grodansparadis/can4vscp_beijing/eagle/Gerbers/bejing_specification.txt

Ake Hedman
Grodans Paradis AB, <akhe@grodansparadis.com>

Date:				2014-06-18
Part Number: 		Beijing
Number of boards: 	120
Number of layers: 	2	 
Material: 			FR4
Final Thickness:	1.6 mm
Final copper:		1/1oz
Surface treatment: 	ENIG
Unit Size:			72 x 42 mm
Panel Size:			154*126 mm
Unit/panel:			6
Solder Mask:		Green
Silk Screen: 		White	
Outline Profile:	CNC Routing + V-cut
X-out Allowed:		1
Stencil needed:		yes
Gerber layer for Stencil: Component Cream (pmc)
