grodansparadis/can4vscp_beijing/docs/_coverpage.md

VSCP logo

# Manual for the Beijing module

Scroll down to view docs.

[Homepage](https://www.vscp.org)
[Docs](https://www.vscp.org/#documentation)
[Get Started](./README)
