grodansparadis/can4vscp_beijing/docs/images/beijing1.png

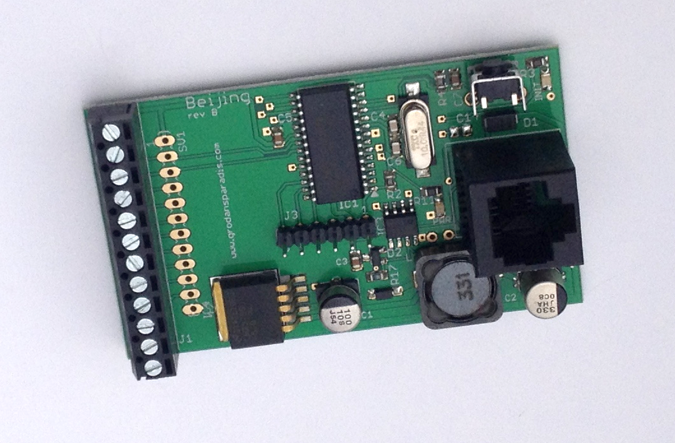
docs/images/beijing1.png
