grodansparadis/can4vscp_beijing/docs/images/beijing2.png

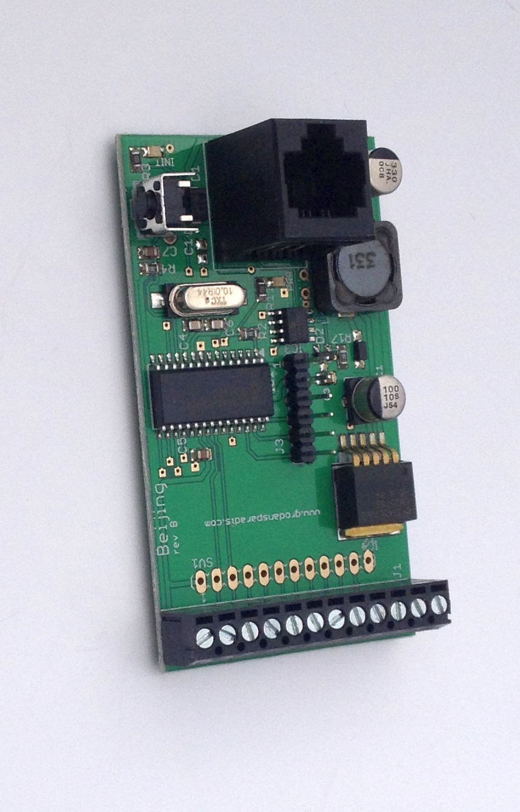
docs/images/beijing2.png
