grodansparadis/can4vscp_beijing/docs/images/beijing4.png

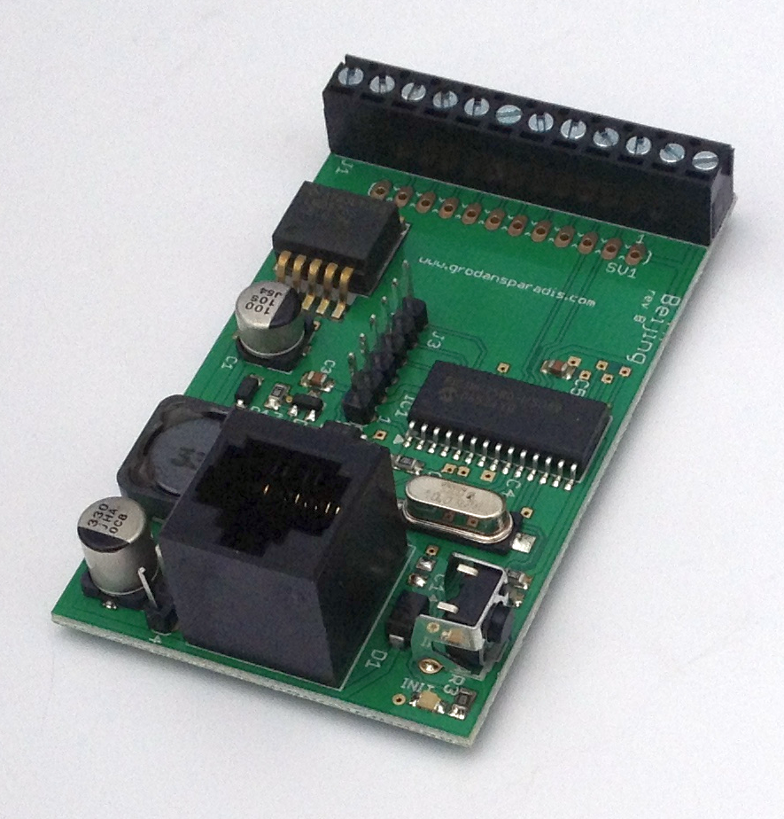
docs/images/beijing4.png
