grodansparadis/can4vscp_beijing/docs/images/beijing5.png

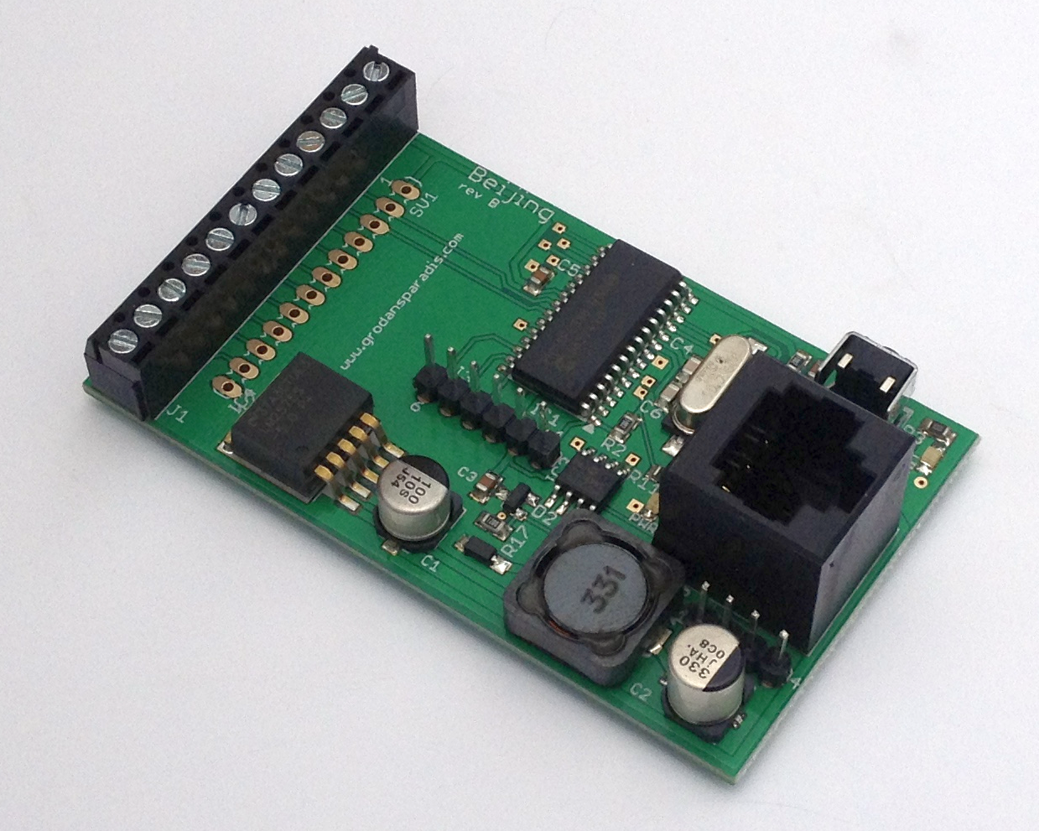
docs/images/beijing5.png
