grodansparadis/can4vscp_beijing/docs/images/beijing6.png

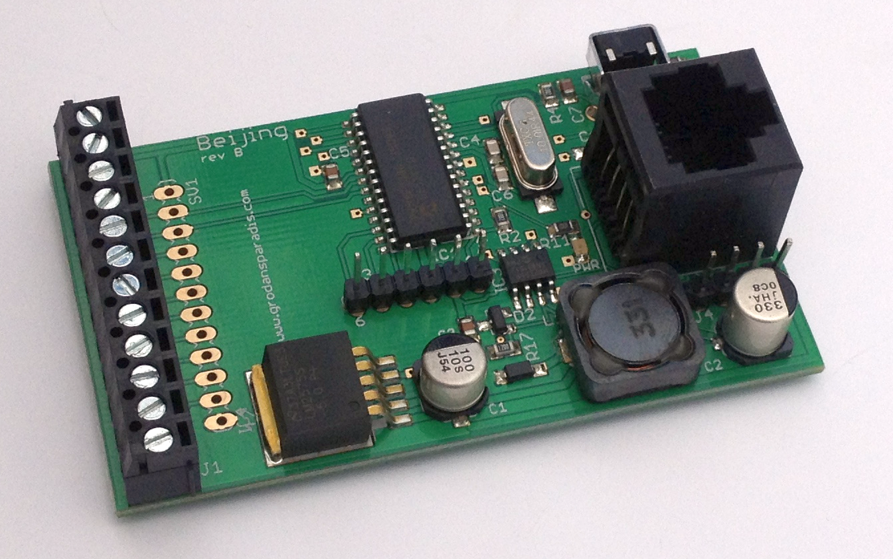
docs/images/beijing6.png
