grodansparadis/can4vscp_beijing/docs/images/beijing7.png

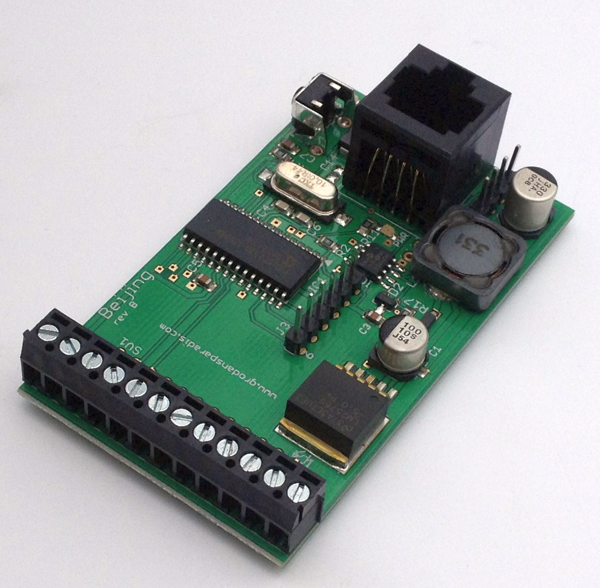
docs/images/beijing7.png
