grodansparadis/can4vscp_beijing/docs/images/beijing8.png

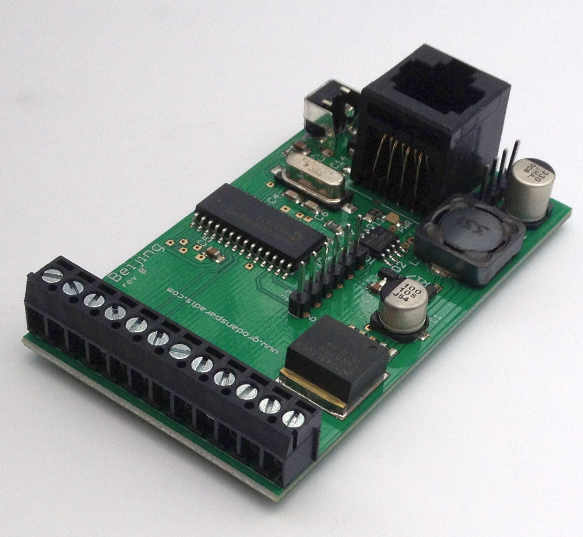
docs/images/beijing8.png
