grodansparadis/can4vscp_beijing/docs/images/beijing9.png

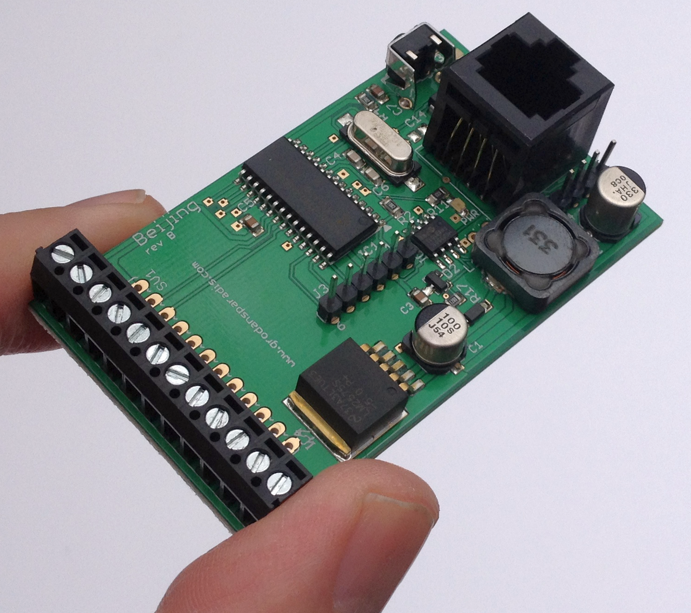
docs/images/beijing9.png
