grodansparadis/can4vscp_beijing/docs/images/beijing10.png

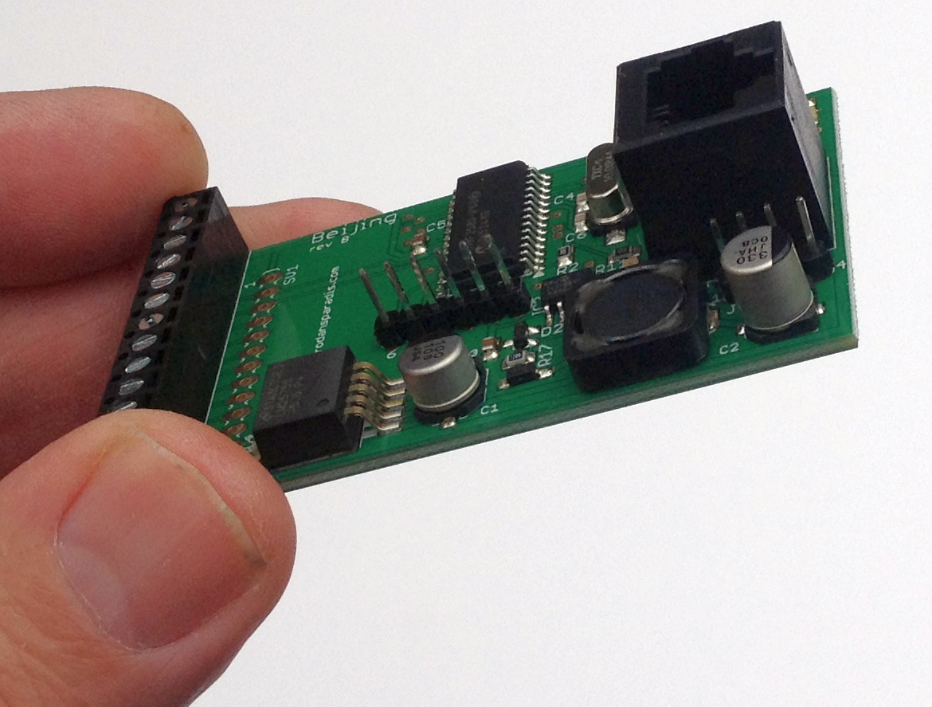
docs/images/beijing10.png
