grodansparadis/can4vscp_beijing/docs/images/beijing11.png

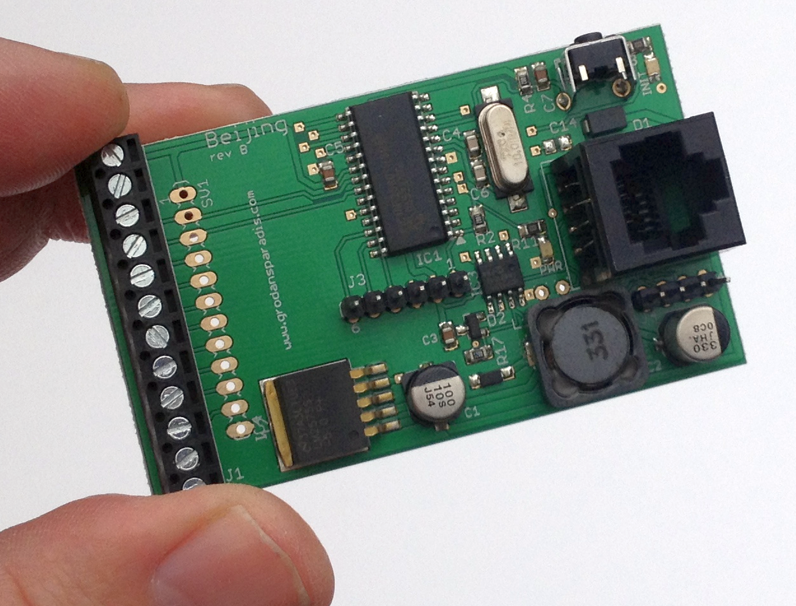
docs/images/beijing11.png
