grodansparadis/can4vscp_beijing/docs/images/beijing11_conectors.png

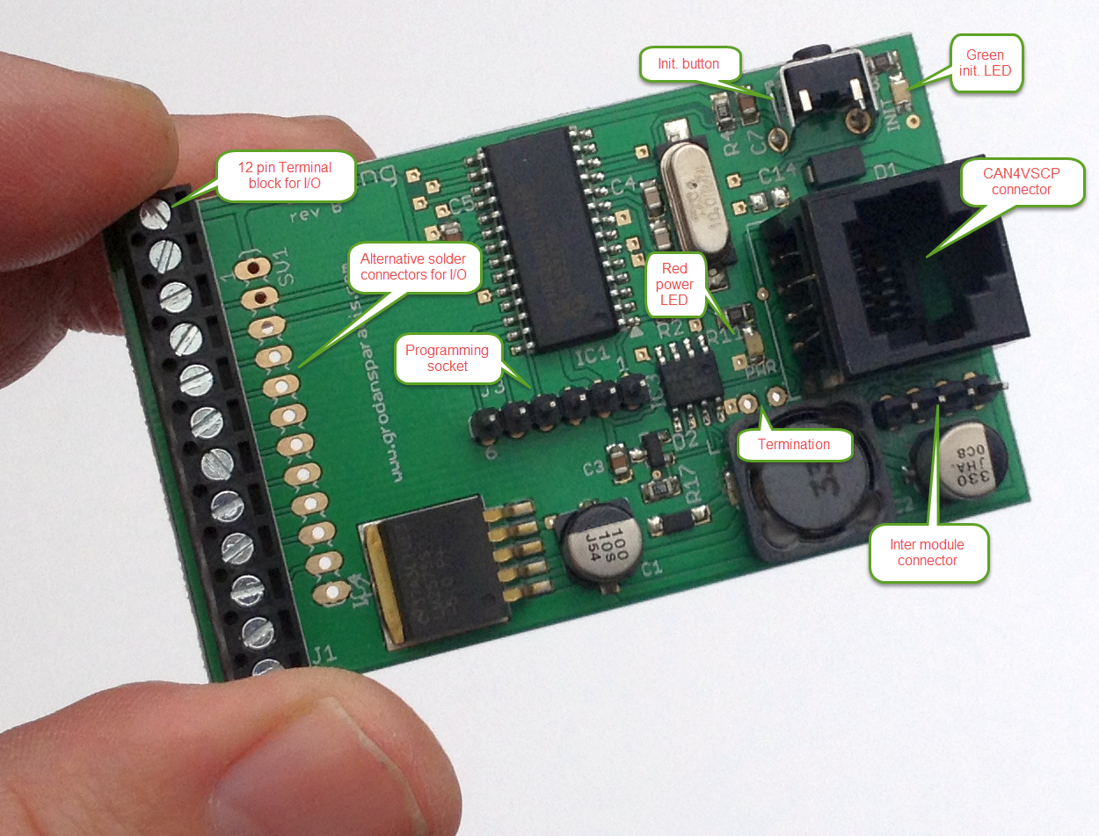
docs/images/beijing11_conectors.png
