grodansparadis/can4vscp_beijing/docs/images/beijing12.png

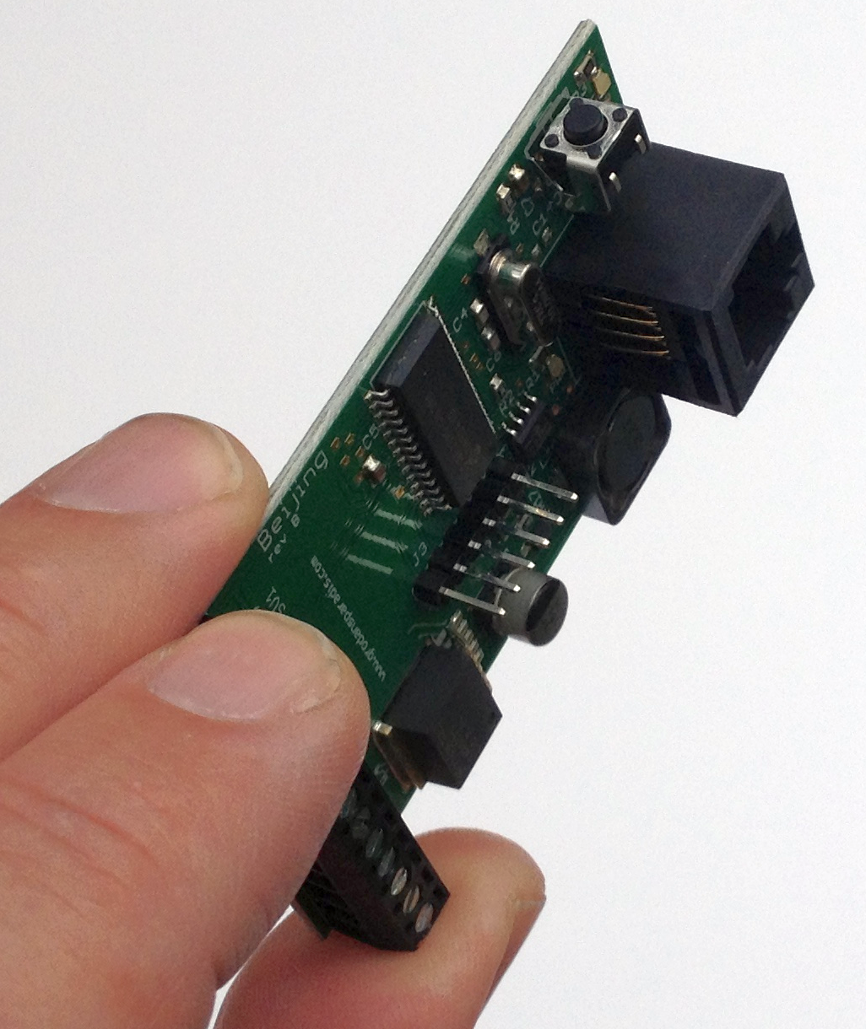
docs/images/beijing12.png
