grodansparadis/can4vscp_beijing/docs/images/beijing13.png

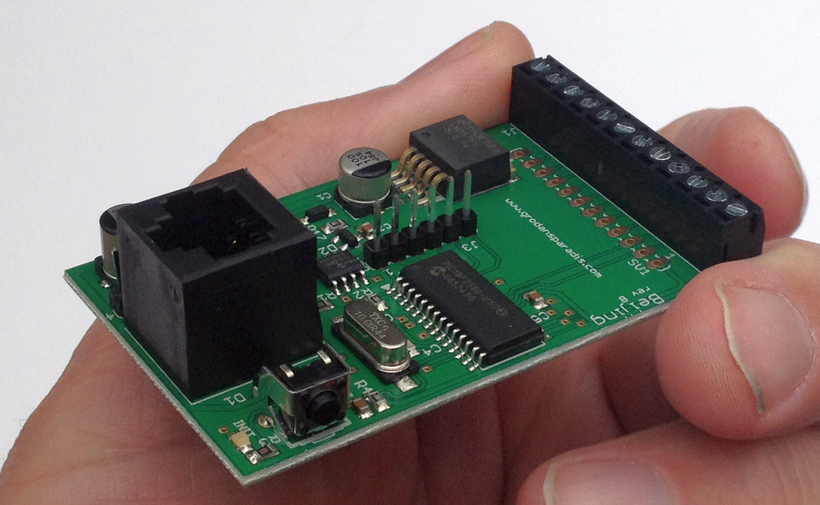
docs/images/beijing13.png
