grodansparadis/can4vscp_beijing/docs/images/beijing14.png

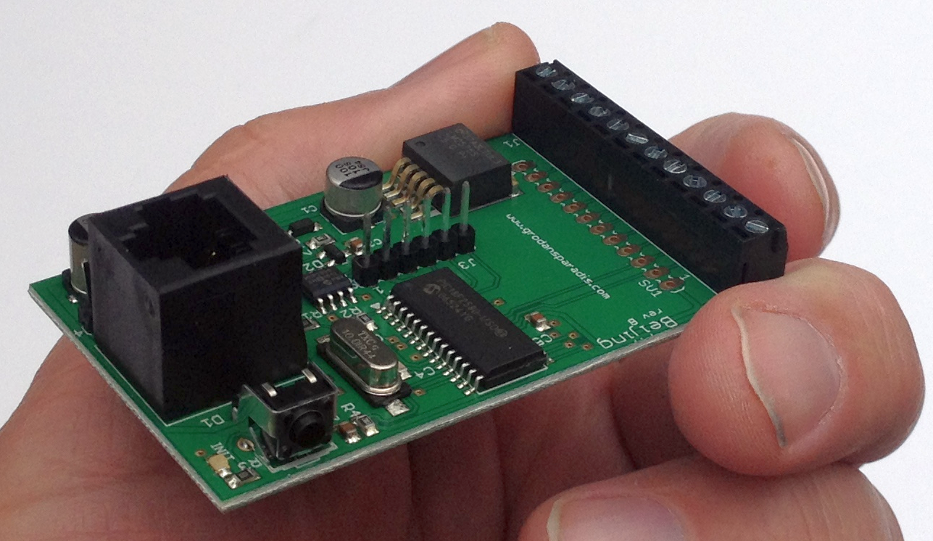
docs/images/beijing14.png
