grodansparadis/can4vscp_beijing/docs/images/beijing15.png

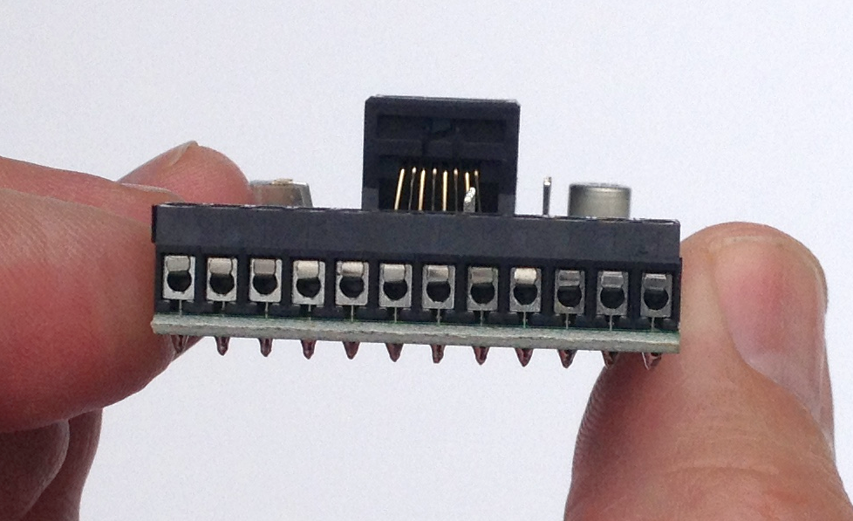
docs/images/beijing15.png
