grodansparadis/can4vscp_beijing/docs/images/beijing15_terminal_block.png

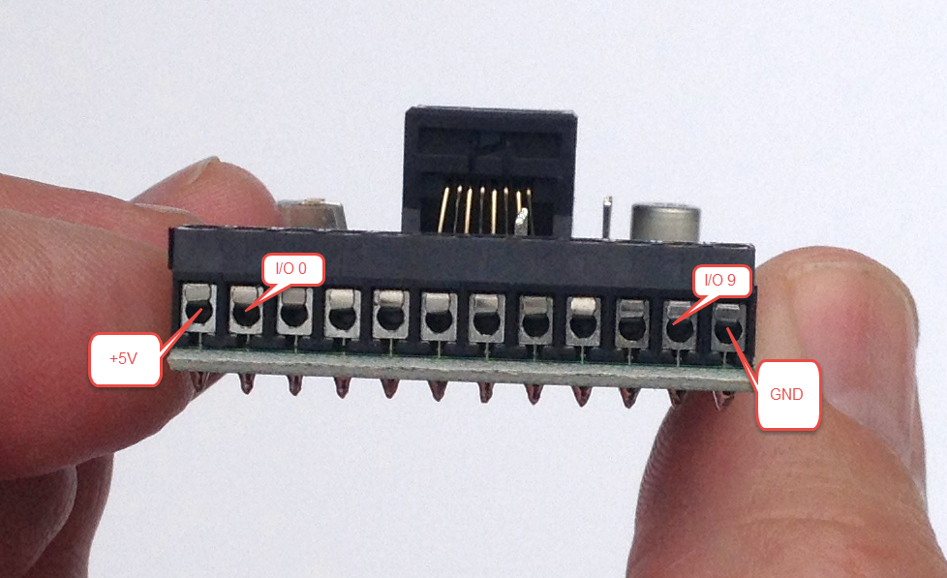
docs/images/beijing15_terminal_block.png
