grodansparadis/can4vscp_beijing/docs/images/beijing_brd_rev_B.png

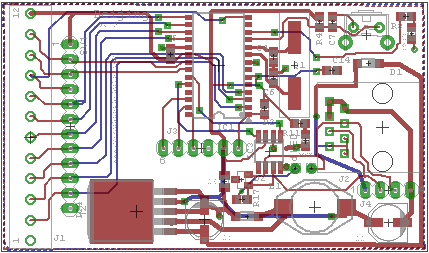
docs/images/beijing_brd_rev_B.png
