grodansparadis/can4vscp_beijing/docs/images/beijing_pulldown.jpg

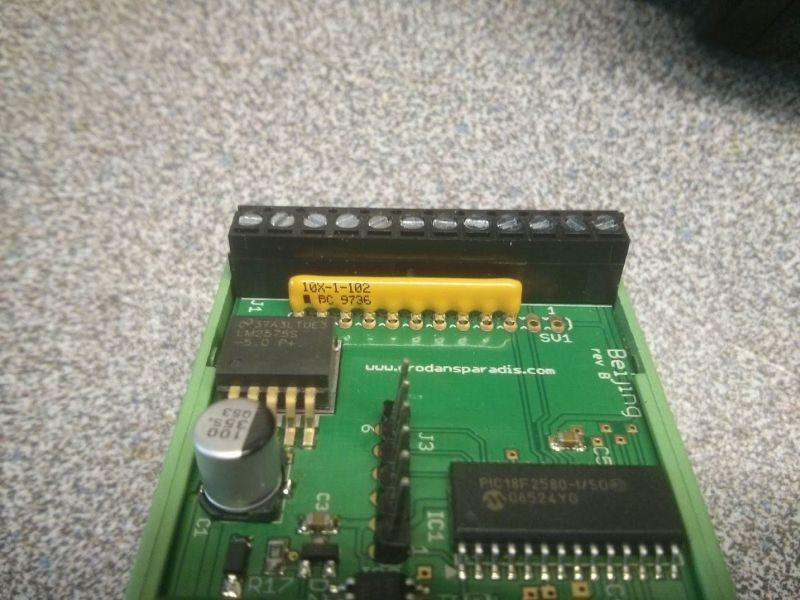
docs/images/beijing_pulldown.jpg
