grodansparadis/can4vscp_beijing/docs/images/beijing_sch_rev_B.png

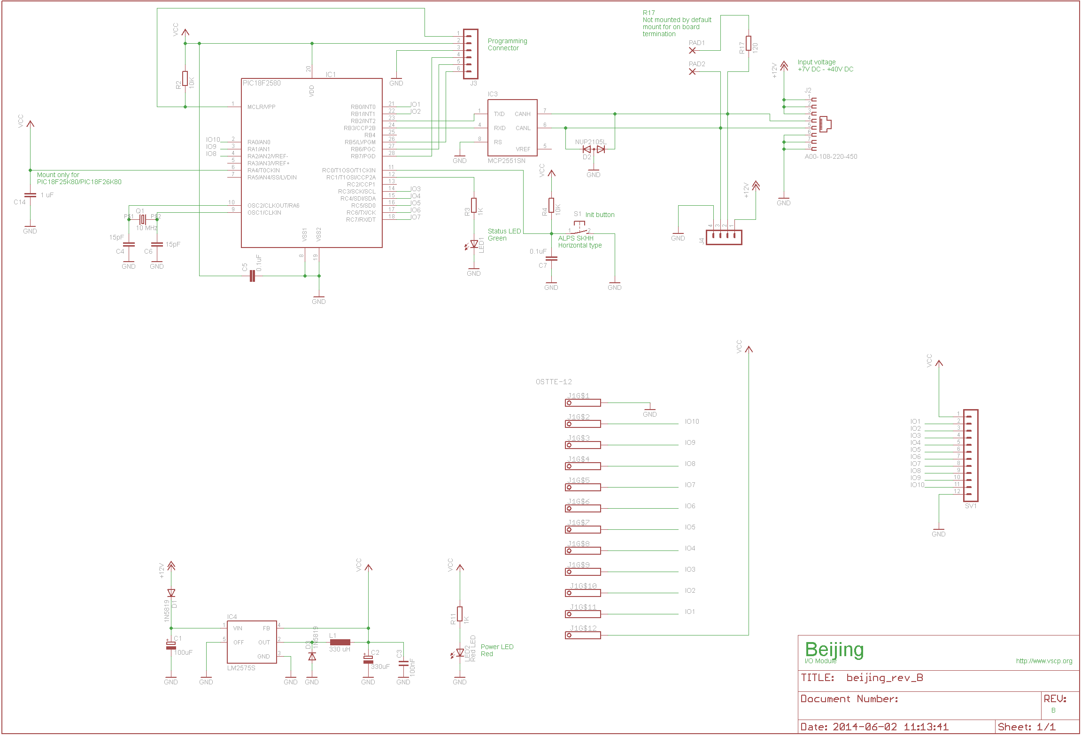
docs/images/beijing_sch_rev_B.png
