grodansparadis/can4vscp_beijing/docs/save/peking_general_i_o_module [the VSCP & Friends Wiki]_files/bejing_small.jpg

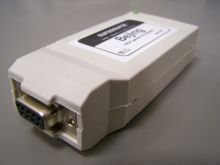
docs/save/peking_general_i_o_module [the VSCP & Friends Wiki]_files/bejing_small.jpg
