grodansparadis/can4vscp_beijing/docs/save/manual/images/termination_block.png

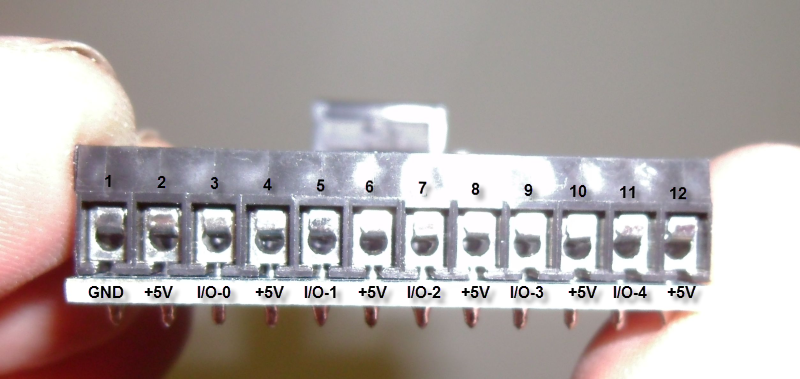
docs/save/manual/images/termination_block.png
