grodansparadis/can4vscp_beijing/docs/save/manual/wiki/manual/data/cache/6/65cc4254584039ab8efa202d597b3e83.media.500x299.png

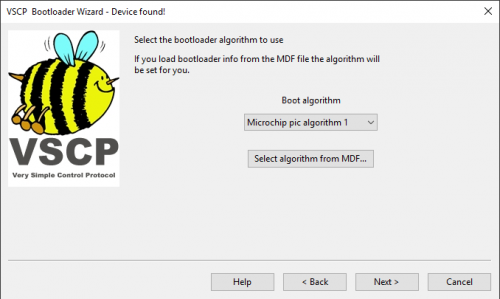
docs/save/manual/wiki/manual/data/cache/6/65cc4254584039ab8efa202d597b3e83.media.500x299.png
