grodansparadis/can4vscp_beijing/docs/history.md

# Change Log for Accra

Change log for the module is at
[here](https://github.com/grodansparadis/can4vscp_accra/blob/master/HISTORY.txt)

| Date | By | Description |
| ---- | -- | ---  |
| 250113 | akhe | Fixed some links |
| 220602 | akhe | Transferred to Markdown format |

[filename](./bottom-copyright.md ':include')
