grodansparadis/can4vscp_beijing/(threads)

Thread 2 (2016-04-27):

Local inputs controlling oputputs

grodansparadis, 2016-04-27:
Btw is there an alternative way to use local inputs to control local outputs? // In case there is no daemon to control it all.

Otherwise it will “cost” two DM lines (one for ON and one for OFF)? // Toggle is no option as a wrong startup could mess-up the toggle (i.e. button off --> lights on, button on --> lights off)
