grodansparadis/can4vscp_beijing/docs/save/manual/images/bejing_a0_io_rev_B.pdf

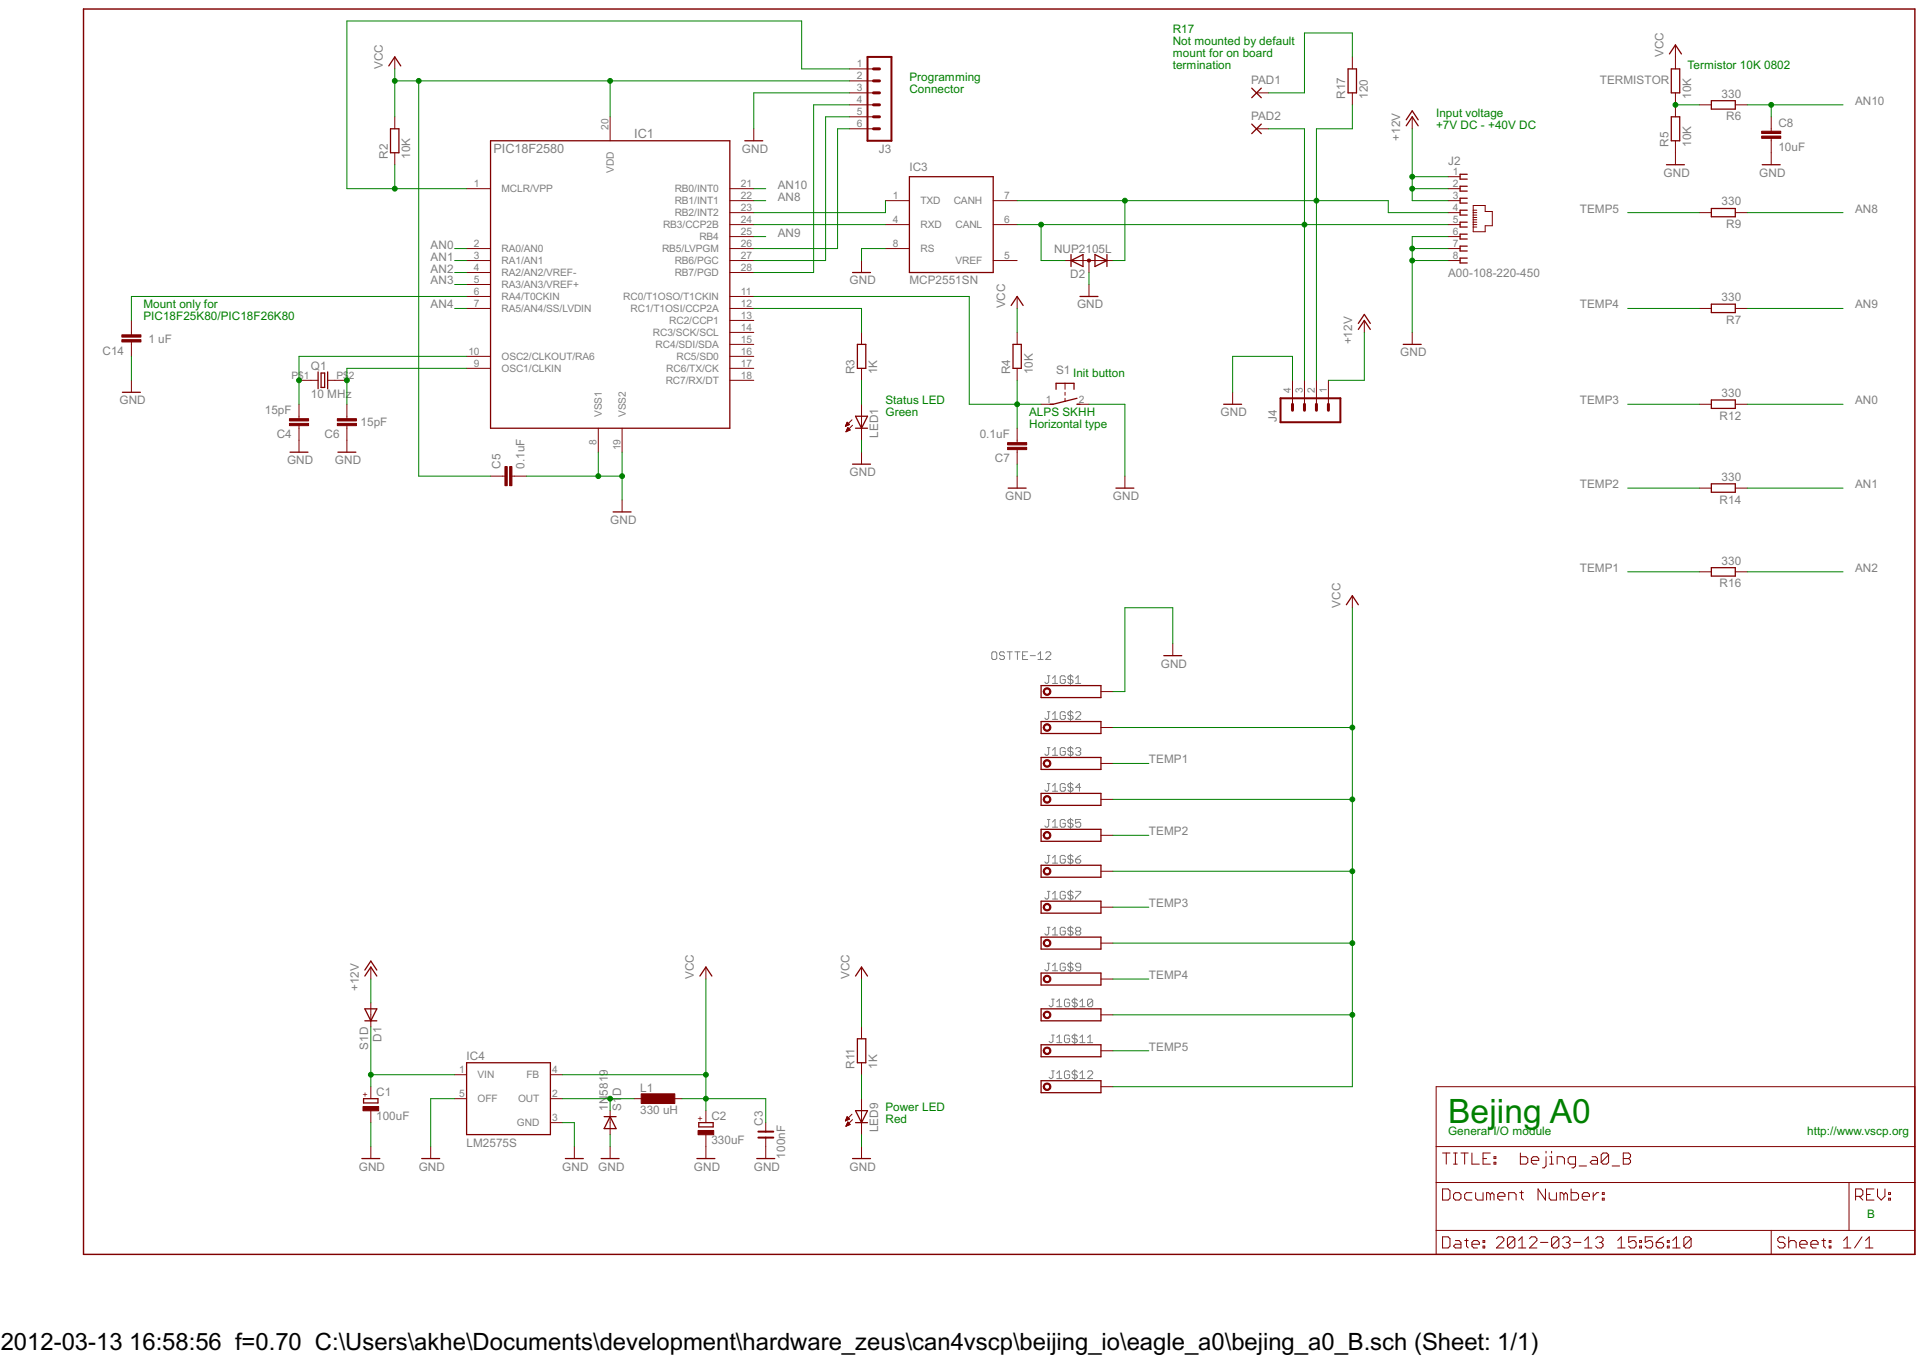
[picture p43: page 1]

termination R17
Not mounted by default mount for on board

Input voltage +7V DC - +40V DC

Init button Status LED

2012-03-13 16:58:56 f=0.70 C:\Users\akhe\Documents\development\hardware_zeus\can4vscp\beijing_io\eagle_a0\bejing_a0_B.sch (Sheet: 1/1)
