grodansparadis/can4vscp_beijing/eagle/Gerbers/Beijing panel.pdf

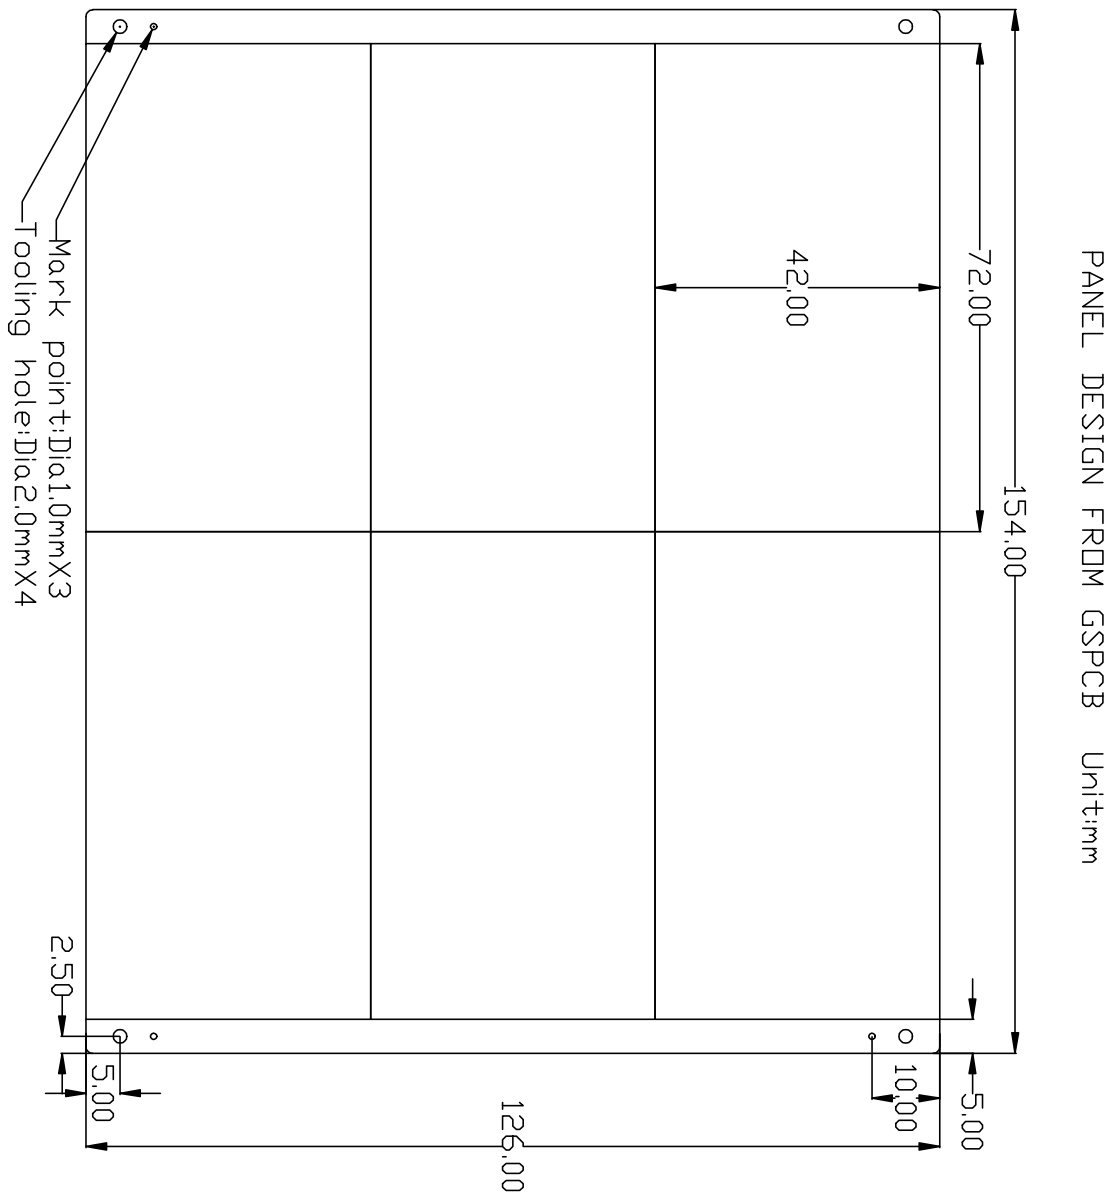
[picture p44: page 1]
