grodansparadis/can4vscp_beijing/eagle/beijing_rev_B.brd

## EAGLE design eagle/beijing_rev_B.brd (2016-04-04)

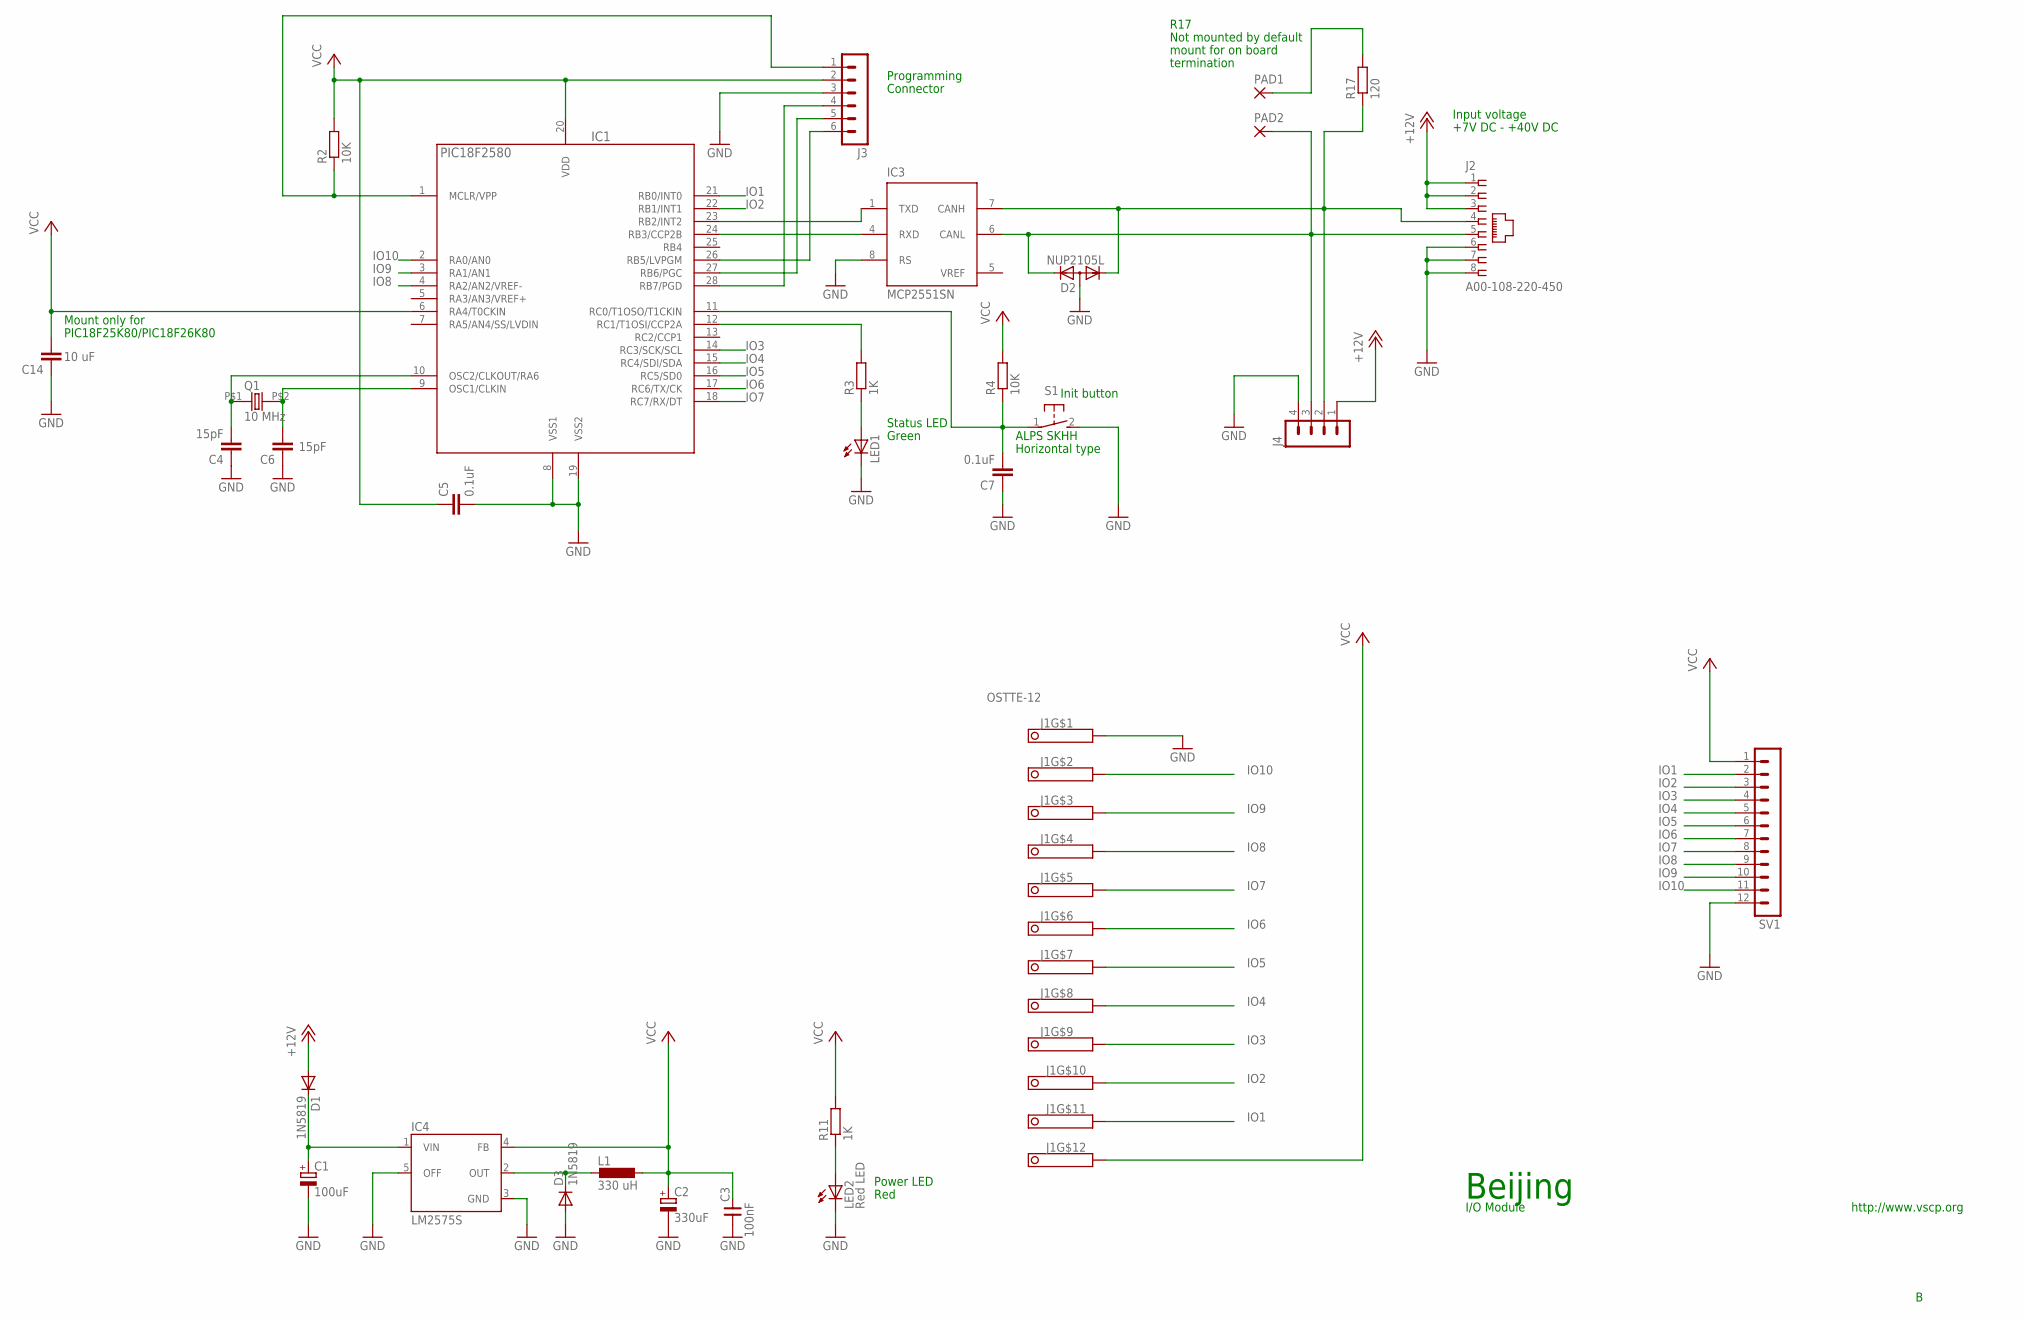
[picture p47: schematic beijing_rev_B.sch]

Parts:
C1: 100uF; PANASONIC_D
C2: 330uF; PANASONIC_D
C3: 100nF; 0805
C4, C6: 15pF; C0805
C5, C7: 0.1uF; C0805
C14: 10 uF; C0805
D1, D3: 1N5819; SOD123
D2: NUP2105L; SOT23
IC1: PIC18F2580; SO28
IC3: MCP2551SN; SO-08
IC4: LM2575S; TO263-5
J1: OSTTE-12; PINHEAD-12
J2: A00-108-220-450; RJ-45
J3: MA06-1
J4: MA04-1
L1: 330 uH; DO3316P
LED1: LEDCHIP-LED0805; CHIP-LED0805
LED2: Red LED; CHIP-LED0805
PAD1, PAD2: 1,6/0,8
Q1: 10 MHz; 9C
R2, R4: 10K; R0805
R3, R11: 1K; R0805
R17: 120; R0805
S1: 31-XX; B3F-31XX
SV1: MA12-1

Connections:
+12V: D1.A, J2.1, J2.2, J2.3, J4.1
CANL: D2.2 (K2), IC3.6 (CANL), J2.5, J4.3, PAD2.1
GND: C1.-, C2.-, C3.1, C4.1, C5.2, C6.1, C7.1, C14.1, D2.3 (A), D3.A, IC1.8 (VSS1), IC1.19 (VSS2), IC3.2 (VSS), IC3.8 (RS), IC4.3 (GND), IC4.5 (OFF), J1.1, J2.6, J2.7, J2.8, J3.3, J4.4, LED1.C, LED2.C, S1.2 (S), SV1.12
IO1: IC1.21 (RB0/INT0), J1.11, SV1.2
IO2: IC1.22 (RB1/INT1), J1.10, SV1.3
IO3: IC1.14 (RC3/SCK/SCL), J1.9, SV1.4
IO4: IC1.15 (RC4/SDI/SDA), J1.8, SV1.5
IO5: IC1.16 (RC5/SD0), J1.7, SV1.6
IO6: IC1.17 (RC6/TX/CK), J1.6, SV1.7
IO7: IC1.18 (RC7/RX/DT), J1.5, SV1.8
IO8: IC1.4 (RA2/AN2/VREF-), J1.4, SV1.9
IO9: IC1.3 (RA1/AN1), J1.3, SV1.10
IO10: IC1.2 (RA0/AN0), J1.2, SV1.11
unnamed: D3.C, IC4.2 (OUT), L1.1
unnamed: C4.2, IC1.10 (OSC2/CLKOUT/RA6), Q1.P$1 (1)
unnamed: C1.+, D1.C, IC4.1 (VIN)
unnamed: IC1.12 (RC1/T1OSI/CCP2A), R3.2
unnamed: LED1.A, R3.1
unnamed: C7.2, IC1.11 (RC0/T1OSO/T1CKIN), R4.1, S1.1
unnamed: C6.2, IC1.9 (OSC1/CLKIN), Q1.P$2 (2)
unnamed: PAD1.1, R17.2
unnamed: IC1.1 (MCLR/VPP), J3.1, R2.1
unnamed: IC1.28 (RB7/PGD), J3.4
unnamed: IC1.27 (RB6/PGC), J3.5
unnamed: IC1.26 (RB5/LVPGM), J3.6
unnamed: LED2.A, R11.1
unnamed: D2.1 (K1), IC3.7 (CANH), J2.4, J4.2, R17.1
RXCAN: IC1.24 (RB3/CCP2B), IC3.4 (RXD)
TXCAN: IC1.23 (RB2/INT2), IC3.1 (TXD)
VCC: C2.+, C3.2, C5.1, C14.2, IC1.6 (RA4/T0CKIN), IC1.20 (VDD), IC3.3 (VDD), IC4.4 (FB), J1.12, J3.2, L1.2, R2.2, R4.2, R11.2, SV1.1
VREF: IC3.5 (VREF)

Notes on the sheet:
Init button
Status LED
Programming
Connector
ALPS SKHH
Horizontal type
Beijing
http://www.vscp.org
I/O Module
Input voltage
+7V DC - +40V DC
Power LED
Red
Green
Mount only for
PIC18F25K80/PIC18F26K80
Not mounted by default
mount for on board
termination
R17

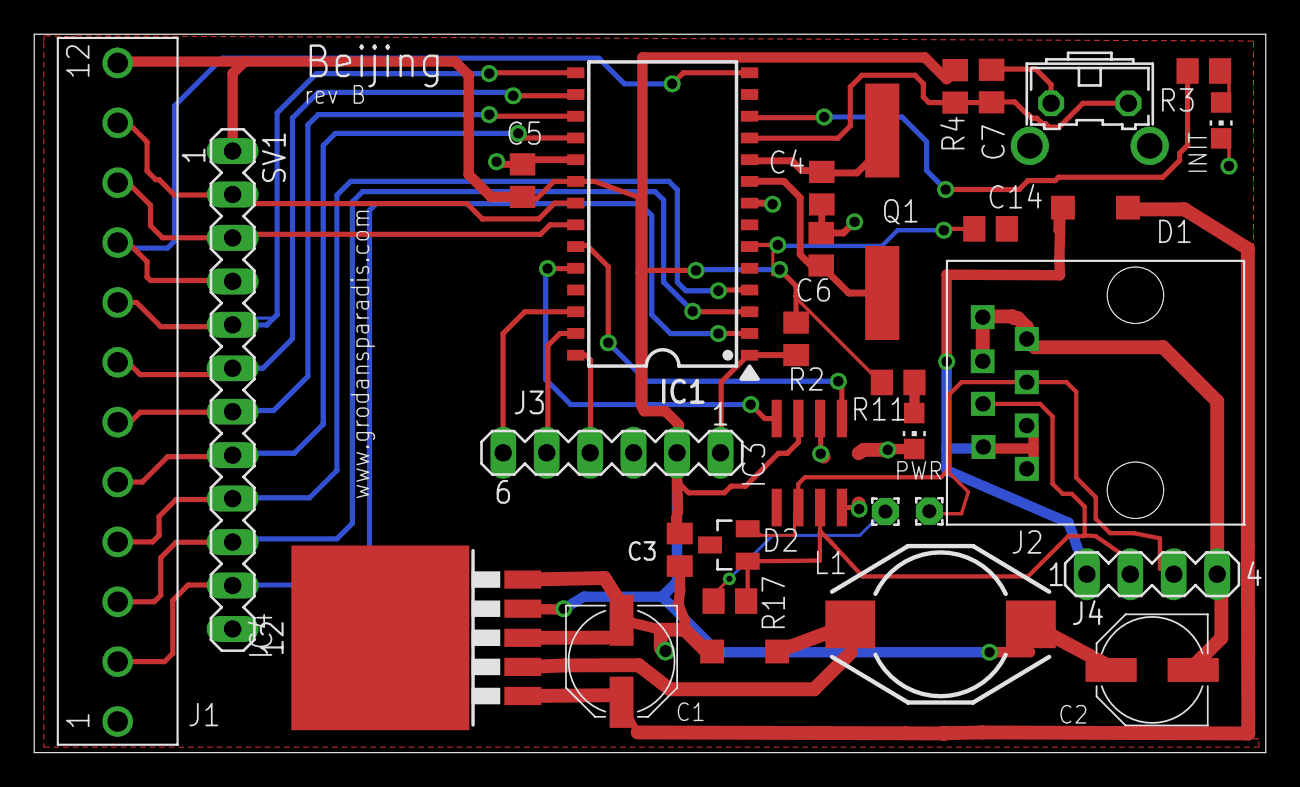
[picture p48: board beijing_rev_B.brd from above]

Board: 2 copper layers, 72.0 x 42.0 mm, 31 parts (0 on the bottom side), 30 nets.
