grodansparadis/can4vscp_beijing/main.c

/* ******************************************************************************
 * 	VSCP (Very Simple Control Protocol) 
 * 	http://www.vscp.org
 *
 *  Beijing I/O module
 *  ==================
 *
 *  Copyright (C)1995-2020 Ake Hedman, Grodans Paradis AB
 *                          http://www.grodansparadis.com
 *                          <akhe@grodansparadis.com>
 *
 *  This work is licensed under the Creative Common 
 *  Attribution-NonCommercial-ShareAlike 3.0 Unported license. The full
 *  license is available in the top folder of this project (LICENSE) or here
 *  http://creativecommons.org/licenses/by-nc-sa/3.0/legalcode
 *  It is also available in a human readable form here 
 *  http://creativecommons.org/licenses/by-nc-sa/3.0/
 * 
 *	This file is part of VSCP - Very Simple Control Protocol 	
 *	http://www.vscp.org
 *
 * ******************************************************************************
 */

#include "vscp_compiler.h"
#include "vscp_projdefs.h"

#include <xc.h>
#include <timers.h>
#include <delays.h>
#include <inttypes.h>
#include <string.h>
#include <ECAN.h>
#include <vscp_firmware.h>
#include <vscp_class.h>
#include <vscp_type.h>
#include "beijing.h"
#include "version.h"


#if defined(_18F2580) 


#if defined(RELEASE)

#pragma config WDT = ON, WDTPS = 128
#pragma config OSC = HSPLL
#pragma config BOREN = BOACTIVE
#pragma config STVREN = ON
#pragma config BORV = 3
#pragma config LVP = ON
#pragma config CPB = ON
#pragma config BBSIZ = 2048
#pragma config WRTD  = OFF

#pragma config EBTR0 = OFF
#pragma config EBTR1 = OFF
#pragma config EBTR2 = OFF
#pragma config EBTR3 = OFF

#pragma config EBTRB = OFF

#else

#pragma config WDT = OFF
#pragma config OSC = HSPLL
#pragma config PWRT = ON
#pragma config BOREN = BOACTIVE
#pragma config STVREN = ON
#pragma config BORV = 3
#pragma config LVP = OFF
#pragma config CPB = OFF
#pragma config WRTD  = OFF

#pragma config EBTR0 = OFF
#pragma config EBTR1 = OFF
#pragma config EBTR2 = OFF
#pragma config EBTR3 = OFF

#pragma config EBTRB = OFF

#endif

#else if defined(_18F25K80) || defined(_18F26K80) || defined(_18F45K80) || defined(_18F46K80) || defined(_18F65K80) || defined(_18F66K80)


// CONFIG1L
#pragma config SOSCSEL = DIG    // RC0/RC is I/O
#pragma config RETEN = OFF      // Ultra low-power regulator is Disabled (Controlled by REGSLP bit).
#pragma config INTOSCSEL = HIGH // LF-INTOSC in High-power mode during Sleep.
#pragma config XINST = OFF      // No extended instruction set

// CONFIG1H
#pragma config FOSC = HS2       // Crystal 10 MHz
#pragma config PLLCFG = ON      // 4 x PLL

// CONFIG2H
#pragma config WDTPS = 1048576  // Watchdog prescaler
#pragma config BOREN = SBORDIS  // Brown out enabled
#pragma config BORV  = 0        // 3.0V

// CONFIG3H
#pragma config CANMX = PORTB    // ECAN TX and RX pins are located on RB2 and RB3, respectively.
#pragma config MSSPMSK = MSK7   // 7 Bit address masking mode.
#pragma config MCLRE = ON       // MCLR Enabled, RE3 Disabled.

// CONFIG4L
#pragma config STVREN = ON      // Stack Overflow Reset enabled
#pragma config BBSIZ = BB2K     // Boot block size 2K

#ifdef DEBUG
#pragma config WDTEN = OFF      // WDT disabled in hardware; SWDTEN bit disabled.
#else
#pragma config WDTEN = ON       // WDT enabled in hardware; 
#endif


#endif

// Handle button inputs
void handleButtonInput( void );

// Calculate and st required filter and mask
// for the current decision matrix
void calculateSetFilterMask( void );

// The device URL (max 32 characters including null termination)
const uint8_t vscp_deviceURL[] = "www.eurosource.se/beijing_2.xml";

volatile unsigned long measurement_clock_sec;  // Clock for one second work


volatile unsigned long measurement_clock_10ms;  // Debounce clock (10 ms)
uint8_t debounce_cnt[ 10 ];                     // Debounce counter
BOOL event_sent[ 10 ];                          // Event markers
uint8_t current_channel_to_check;               // I/O channel to check
uint8_t shortpulse[ 10 ];                       // Short pulse timings (10ms))
volatile uint8_t informOffEvent;                // if bit 7 set a CLASS1.CONTROL
                                                // off event should be sent. idx
                                                // is in low bits.

uint16_t sendTimer; // Timer for CAN send
uint8_t seconds;    // counter for seconds
uint8_t minutes;    // counter for minutes
uint8_t hours;      // Counter for hours

// Bit set for channel that should pulse
// bit 0 - channel 0 etc
uint16_t channel_pulse_flags;

// An array with 16-bit timers one
// for each channel
uint16_t channel_pulse_timer[10];

// An array with 16-bit timers one
// for each channel
uint16_t channel_protection_timer[10];

// This is the I/O-state when the last one second work
// was carried out
uint16_t current_iostate;

//__EEPROM_DATA(0x11,0x22,0x33,0x44,0x55,0x66,0x77,0x88);

///////////////////////////////////////////////////////////////////////////////
// Isr() 	- Interrupt Service Routine
//      	- Services Timer0 Overflow
//      	- Services GP3 Pin Change
//////////////////////////////////////////////////////////////////////////////

#ifdef RELOCATE

#else

#endif

void interrupt low_priority  interrupt_at_low_vector( void )
{
    // Clock
    if ( INTCONbits.TMR0IF ) { // If a Timer0 Interrupt, Then...

        // Reload value for 1 ms resolution
        WriteTimer0(TIMER0_RELOAD_VALUE);
        
        vscp_timer++;
        vscp_configtimer++;
        measurement_clock_10ms++;
        measurement_clock_sec++;
        sendTimer++;

        // Check for init. button
        if ( INIT_BUTTON ) {
            vscp_initbtncnt = 0;
        } 
        else {
            // Active
            vscp_initbtncnt++;
        }

        // Status LED
        vscp_statuscnt++;
        if ( ( VSCP_LED_BLINK1 == vscp_initledfunc ) &&
                ( vscp_statuscnt > 100 ) ) {

            if ( STATUS_LED ) {
                STATUS_LED = 0;
            }
            else {
                STATUS_LED = 1;
            }

            vscp_statuscnt = 0;

        }
        else if (VSCP_LED_ON == vscp_initledfunc) {
            STATUS_LED = 1;
            vscp_statuscnt = 0;
        }
        else if (VSCP_LED_OFF == vscp_initledfunc) {
            STATUS_LED = 0;
            vscp_statuscnt = 0;
        }
        
        
        ////////////////////////////////////////////////////////////////
        //                    Short pulse logic
        ////////////////////////////////////////////////////////////////
        if (shortpulse[ 0 ]) {
            shortpulse[ 0 ]--;
            if (!shortpulse[ 0 ]) {
                CHANNEL0 = 0; // Turn off
                informOffEvent = 0x80;
            }
        }

        if (shortpulse[ 1 ]) {
            shortpulse[ 1 ]--;
            if (!shortpulse[ 1 ]) {
                CHANNEL1 = 0; // Turn off
                informOffEvent = 0x81;
            }
        }

        if (shortpulse[ 2 ]) {
            shortpulse[ 2 ]--;
            if (!shortpulse[ 2 ]) {
                CHANNEL2 = 0; // Turn off
                informOffEvent = 0x82;
            }
        }

        if (shortpulse[ 3 ]) {
            shortpulse[ 3 ]--;
            if (!shortpulse[ 3 ]) {
                CHANNEL3 = 0; // Turn off
                informOffEvent = 0x83;
            }
        }

        if (shortpulse[ 4 ]) {
            shortpulse[ 4 ]--;
            if (!shortpulse[ 4 ]) {
                CHANNEL4 = 0; // Turn off
                informOffEvent = 0x84;
            }
        }

        if (shortpulse[ 5 ]) {
            shortpulse[ 5 ]--;
            if (!shortpulse[ 5 ]) {
                CHANNEL5 = 0; // Turn off
                informOffEvent = 0x85;
            }
        }

        if (shortpulse[ 6 ]) {
            shortpulse[ 6 ]--;
            if (!shortpulse[ 6 ]) {
                CHANNEL6 = 0; // Turn off
                informOffEvent = 0x86;
            }
        }

        if (shortpulse[ 7 ]) {
            shortpulse[ 7 ]--;
            if (!shortpulse[ 7 ]) {
                CHANNEL7 = 0; // Turn off
                informOffEvent = 0x87;
            }
        }

        if (shortpulse[ 8 ]) {
            shortpulse[ 8 ]--;
            if (!shortpulse[ 8 ]) {
                CHANNEL8 = 0; // Turn off
                informOffEvent = 0x88;
            }
        }

        if (shortpulse[ 9 ]) {
            shortpulse[ 9 ]--;
            if (!shortpulse[ 9 ]) {
                CHANNEL9 = 0; // Turn off
                informOffEvent = 0x89;
            }
        }
        

        INTCONbits.TMR0IF = 0; // Clear Timer0 Interrupt Flag

    }

    return;
}


//***************************************************************************
// Main() - Main Routine
//***************************************************************************


void main()
{
    init();         // Initialize Micro controller
    
    // Check VSCP persistent storage and
    // restore if needed
    vscp_check_pstorage();
    
    // Initialize data
    init_app_ram();
        
    // Initialize the VSCP functionality
    vscp_init();
    
    // Init. filter for DM
    calculateSetFilterMask();
    
    while ( 1 ) {   // Loop Forever

        ClrWdt();   // Feed the dog

        if ( ( vscp_initbtncnt > 2500 ) && 
             ( VSCP_STATE_INIT != vscp_node_state ) ) {

            // Init. button pressed
            vscp_initledfunc = VSCP_LED_BLINK1;
            vscp_nickname = VSCP_ADDRESS_FREE;
            eeprom_write( VSCP_EEPROM_NICKNAME, VSCP_ADDRESS_FREE );
            vscp_init();
            
        }

        // Check for a valid  event
        vscp_imsg.flags = 0;
        vscp_getEvent();

        switch ( vscp_node_state ) {

            case VSCP_STATE_STARTUP: // Cold/warm reset

                // Get nickname from EEPROM
                if (VSCP_ADDRESS_FREE == vscp_nickname) {
                    // new on segment need a nickname
                    vscp_node_state = VSCP_STATE_INIT;
                } 
                else {
                    // been here before - go on
                    vscp_node_state = VSCP_STATE_ACTIVE;
                    vscp_goActiveState();
                }
                break;

            case VSCP_STATE_INIT: // Assigning nickname
                vscp_handleProbeState();
                break;

            case VSCP_STATE_PREACTIVE:  // Waiting for host initialization
                vscp_goActiveState();
                break;

            case VSCP_STATE_ACTIVE:     // The normal state

                // Check for incoming event?
                if (vscp_imsg.flags & VSCP_VALID_MSG) {

                    if ( VSCP_CLASS1_PROTOCOL == vscp_imsg.vscp_class  ) {

                        // Handle protocol event
                        vscp_handleProtocolEvent();

                    }
                    else {    
                        doDM();
					}
                    
                }
                
                // Should off event be sent?
                if ( informOffEvent & 0x80 ) {
                    if ( eeprom_read( VSCP_EEPROM_END + REG0_BEIJING_CH0_OUTPUT_CTRL + (informOffEvent & 0x0f) ) & OUTPUT_CTRL_OFFEVENT ) {
                        SendInformationEvent( informOffEvent & 0x0f, VSCP_CLASS1_INFORMATION, VSCP_TYPE_INFORMATION_OFF );
                    }
                    informOffEvent = 0;
                }
                
                ///////////////////////////////////////////////////////////////
                //                  B U T T O N   L O G I C
                //////////////////////////////////////////////////////////////
                if ( measurement_clock_10ms >= 10 ) {
                    
                    measurement_clock_10ms = 0;
                    
                    uint16_t dir = 
                        ( (uint16_t)eeprom_read( VSCP_EEPROM_END +
                                        REG0_BEIJING_IO_DIRECTION_MSB ) << 8 ) +
                        (uint16_t)eeprom_read( VSCP_EEPROM_END +
                                        REG0_BEIJING_IO_DIRECTION_LSB );

                    if ( ( dir & ( 1 << current_channel_to_check ) ) &&     // Input))
                            ( eeprom_read( VSCP_EEPROM_END +                // debounce
                                            REG0_BEIJING_CH0_INPUT_CTRL +
                                            current_channel_to_check ) &
                                                INPUT_CTRL_DEBOUNCE ) &&
                            ( eeprom_read( VSCP_EEPROM_END +                // Enabled
                                            REG0_BEIJING_CH0_INPUT_CTRL +
                                            current_channel_to_check ) &
                                                INPUT_CTRL_ENABLE ) ) {
                        
                        // Here if channel is enabled and set as input and debounce 
                        // is enabled
      
                        switch ( current_channel_to_check ) {

                            case 0:
                                if ( !CHANNEL0 ) {                                    
                                    handleButtonInput();
                                } 
                                else {
                                    debounce_cnt[ current_channel_to_check ] = 0;
                                    event_sent[ current_channel_to_check ] = FALSE;
                                }
                                break;

                            case 1:
                                if (!CHANNEL1) {
                                    handleButtonInput();
                                } 
                                else {
                                    debounce_cnt[ current_channel_to_check ] = 0;
                                    event_sent[ current_channel_to_check ] = FALSE;
                                }
                                break;

                            case 2:
                                if (!CHANNEL2) {
                                    handleButtonInput();
                                } 
                                else {
                                    debounce_cnt[ current_channel_to_check ] = 0;
                                    event_sent[ current_channel_to_check ] = FALSE;
                                }
                                break;

                            case 3:
                                if (!CHANNEL3) {
                                    handleButtonInput();
                                } 
                                else {
                                    debounce_cnt[ current_channel_to_check ] = 0;
                                    event_sent[ current_channel_to_check ] = FALSE;
                                }
                                break;

                            case 4:
                                if (!CHANNEL4) {
                                    handleButtonInput();
                                } 
                                else {
                                    debounce_cnt[ current_channel_to_check ] = 0;
                                    event_sent[ current_channel_to_check ] = FALSE;
                                }
                                break;

                            case 5:
                                if (!CHANNEL5) {
                                    handleButtonInput();
                                } 
                                else {
                                    debounce_cnt[ current_channel_to_check ] = 0;
                                    event_sent[ current_channel_to_check ] = FALSE;
                                }
                                break;

                            case 6:
                                if (!CHANNEL6) {
                                    handleButtonInput();
                                } 
                                else {
                                    debounce_cnt[ current_channel_to_check ] = 0;
                                    event_sent[ current_channel_to_check ] = FALSE;
                                }
                                break;

                            case 7:
                                if (!CHANNEL7) {
                                    handleButtonInput();
                                } 
                                else {
                                    debounce_cnt[ current_channel_to_check ] = 0;
                                    event_sent[ current_channel_to_check ] = FALSE;
                                }
                                break;

                            case 8:
                                if (!CHANNEL8) {
                                    handleButtonInput();
                                } 
                                else {
                                    debounce_cnt[ current_channel_to_check ] = 0;
                                    event_sent[ current_channel_to_check ] = FALSE;
                                }
                                break;

                            case 9:
                                if ( !CHANNEL9 ) {
                                    handleButtonInput();
                                } 
                                else {
                                    debounce_cnt[ current_channel_to_check ] = 0;
                                    event_sent[ current_channel_to_check ] = FALSE;
                                }
                                break;

                            default:
                                current_channel_to_check = 0;
                                break;
                        }

                    }                    
                    
                    current_channel_to_check++;
                    if ( current_channel_to_check > 9 ) current_channel_to_check = 0;
                    
                    
                }
                break;

            case VSCP_STATE_ERROR: // Everything is *very* *very* bad.
                vscp_error();
                break;

            default: // Should not be here...
                vscp_node_state = VSCP_STATE_STARTUP;
                break;

        }

        // do a measurement if needed
        if ( measurement_clock_sec > 1000 ) {

            measurement_clock_sec = 0;
            seconds++;
 
            // Do VSCP one second jobs
            vscp_doOneSecondWork();

            // Temperature report timers are only updated if in active
            // state GUID_reset
            if ( VSCP_STATE_ACTIVE == vscp_node_state ) {
                
                // Do VSCP one second jobs
                doApplicationOneSecondWork();
                
            }

        }

        // Timekeeping
        if ( seconds > 59 ) {

            seconds = 0;
            minutes++;

            if ( minutes > 59 ) {
                minutes = 0;
                hours++;
            }

            if ( hours > 23 ) hours = 0;

        }

        doWork();

    } // while
}

///////////////////////////////////////////////////////////////////////////////
// handleButtonInput
//

void handleButtonInput( void )
{
    debounce_cnt[ current_channel_to_check ]++;
                                    
    if ( debounce_cnt[ current_channel_to_check ] > 
        eeprom_read( VSCP_EEPROM_END + 
                        REG0_BEIJING_DEBOUNCE_COUNT ) ) {
                                        
        debounce_cnt[ current_channel_to_check ] = 0;
                                       
        // Send TurnOff/TurnOn event
        if ( eeprom_read(VSCP_EEPROM_END +
                REG0_BEIJING_CH0_INPUT_CTRL +
                current_channel_to_check ) &
                    INPUT_CTRL_EVENT_SELECT ) {
                                            
            // Send event if repeat is on 
            //   OR 
            // repeat is off and no event has been sent
            if ( !( eeprom_read( VSCP_EEPROM_END + REG0_BEIJING_MODULE_CTRL ) & 
                    MODULE_CTRL_DISABLE_REPEAT ) || 
                    ( !event_sent[ current_channel_to_check ] && 
                    ( eeprom_read( VSCP_EEPROM_END + REG0_BEIJING_MODULE_CTRL ) & 
                        MODULE_CTRL_DISABLE_REPEAT ) ) ) {
                                            
                SendInformationEvent( current_channel_to_check,
                                        VSCP_CLASS1_CONTROL,
                                        VSCP_TYPE_CONTROL_TURNOFF );
                                            
                event_sent[ current_channel_to_check ] = TRUE;
                                            
            }
                                            
        } 
        else {
                                            
            // Send event if repeat is on 
            //   OR 
            // repeat is off and no event has been sent
            if ( !( eeprom_read( VSCP_EEPROM_END + REG0_BEIJING_MODULE_CTRL ) & 
                        MODULE_CTRL_DISABLE_REPEAT ) || 
                    ( !event_sent[ current_channel_to_check ] && 
                    ( eeprom_read( VSCP_EEPROM_END + REG0_BEIJING_MODULE_CTRL ) & 
                        MODULE_CTRL_DISABLE_REPEAT ) ) ) {
                                            
                SendInformationEvent( current_channel_to_check,
                                        VSCP_CLASS1_CONTROL,
                                        VSCP_TYPE_CONTROL_TURNON);
                                            
                event_sent[ current_channel_to_check ] = TRUE;
            
            }
                                            
        }
        
    }
}


///////////////////////////////////////////////////////////////////////////////
// Init. - Initialization Routine
//  

void init()
{   
    //uint8_t msgdata[ 8 ];

    // Initialize the uP
    
    // Deselect comparators and ADC's so PORTA/PORTB
    // can be used as inputs.
    ADCON1 = 0x0f;
    //CMCON = 0x07;     // Not implemented on PIC18F2580

    // PORTA
    // RA0/AN0  - channel 9
    // RA1/AN1  - channel 8
    // RA2/AN2  - channel 7
    // RA3/AN3  - output
    // RA4 input (VCAP for PIC18F26K80))
    // RA5/AN4  - output
    PORTA = 0x00;  // Default off
    TRISA = 0b00010000;
    

    // PortB

    // RB0/AN10     - Channel 0
    // RB1/AN8      - Channel 1
    // RB2 CAN TX   - output
    // RB3 CAN RX   - input
    // RB4/AN9      - Not used = output.
    // RB5/LVPGM    - Not used = output.
    // RB&/PGC      - Not used = output.
    // RB7/PGD      - Not used = output.
    PORTB = 0x00;  // Default off
    TRISB = 0b00001000;
    

    // RC0 - Input  - Init. button
    // RC1 - Output - Status LED - Default off
    // RC2 - Output - Not used = output.
    // RC3 - Output - Channel 2.
    // RC4 - Output - Channel 3.
    // RC5 - Output - Channel 4.
    // RC6 - Output - Channel 5.
    // RC7 - Output - Channel 6.
    PORTC = 0x00;   // Default off
    TRISC = 0b00000001;
    

/*
    // Sensor 0 timer
    OpenTimer0( TIMER_INT_OFF &
                    T0_16BIT &
                    T0_PS_1_2 &
                    T0_SOURCE_INT);

    // Sensor 1 timer
    OpenTimer1( TIMER_INT_OFF &
                    T1_16BIT_RW &
                    T1_SOURCE_INT &
                    T1_PS_1_1 &
                    T1_OSC1EN_OFF &
                    T1_SYNC_EXT_OFF);

    // Timer 2 is used as a 1 ms clock
    // 156 is loaded eight time to give ~1250 cycles
    PR2 = TIMER2_RELOAD_VALUE; // Set reload value
    OpenTimer2( TIMER_INT_ON &
                    T2_PS_1_4 &
                    T2_POST_1_16 );

 */

    OpenTimer0( TIMER_INT_ON & T0_16BIT & T0_SOURCE_INT & T0_PS_1_8 );
    WriteTimer0( TIMER0_RELOAD_VALUE );

    // Set channels to there off position
    CHANNEL0 = 0;
    CHANNEL1 = 0;
    CHANNEL2 = 0;
    CHANNEL3 = 0;
    CHANNEL4 = 0;
    CHANNEL5 = 0;
    CHANNEL6 = 0;
    CHANNEL7 = 0;
    CHANNEL8 = 0;
    CHANNEL9 = 0;

    // Initialize CAN
    ECANInitialize();

    // Must be in config. mode to change many of settings.
    //ECANSetOperationMode(ECAN_OP_MODE_CONFIG);

    // Return to Normal mode to communicate.
    //ECANSetOperationMode(ECAN_OP_MODE_NORMAL);

    /*
        msgdata[ 0 ] = 1;
            msgdata[ 1 ] = 2;
            msgdata[ 2 ] = 3;
            msgdata[ 3 ] = 4;

            if ( vscp18f_sendMsg( 0x123,  msgdata, 4, CAN_TX_PRIORITY_0 & CAN_TX_XTD_FRAME & CAN_TX_NO_RTR_FRAME ) ) {
                    ;
            }

     */
    
    // Enable peripheral interrupt
    INTCONbits.PEIE = 1;

    // Enable global interrupt
    INTCONbits.GIE = 1;

    return;
}

///////////////////////////////////////////////////////////////////////////////
// init_app_ram
//

void init_app_ram( void )
{
    uint8_t i;
    uint8_t dir;

    measurement_clock_sec = 0;      // start a new measurement cycle

    seconds = 0;
    minutes = 0;
    hours = 0;

    channel_pulse_flags = 0;      // No pulse outputs yet

    // Clear timers
    memset( channel_pulse_timer, 0, sizeof( channel_pulse_timer ) );
    memset( channel_protection_timer, 0, sizeof( channel_protection_timer ) );

    for ( i=0; i<10; i++ ) {

        // Init. pulsed channels
        if ( eeprom_read( VSCP_EEPROM_END + REG0_BEIJING_CH0_OUTPUT_CTRL + i ) &
                                OUTPUT_CTRL_PULSE ) {

            channel_pulse_flags |= (1<<i); // Enable pulse output
            channel_pulse_timer[ i ] =
                eeprom_read( VSCP_EEPROM_END + REG0_COUNT + REG1_BEIJING_CH0_TIMING_PULSE_MSB + i ) * 256 +
                eeprom_read( VSCP_EEPROM_END + REG0_COUNT + REG1_BEIJING_CH0_TIMING_PULSE_LSB + i );
        }

        // Init. protection timers
        if ( eeprom_read(VSCP_EEPROM_END + REG0_BEIJING_CH0_OUTPUT_CTRL + i ) & OUTPUT_CTRL_PROTECTION) {
            channel_protection_timer[ i ] =
                eeprom_read(VSCP_EEPROM_END + REG0_COUNT + REG1_BEIJING_CH0_TIMING_PULSE_MSB + i ) * 256 +
                eeprom_read(VSCP_EEPROM_END + REG0_COUNT + REG1_BEIJING_CH0_TIMING_PULSE_LSB + i );
        }

    }
    
    // Init. short pulse timings
    memset( shortpulse, 0, sizeof( shortpulse ) );
    
    dir = eeprom_read( VSCP_EEPROM_END + REG0_BEIJING_IO_DIRECTION_MSB );
    TRISA = ( dir & 0x03 ) | 0b00000000;    // Channel 8/9

    dir = eeprom_read( VSCP_EEPROM_END + REG0_BEIJING_IO_DIRECTION_LSB );
    TRISB = ( dir & 0x03 ) | 0b00001000;    // Channel 0/1
    
    dir = ( dir >> 5 ) & 0b00000100;        // Channel 7
    TRISA |= dir;
            
    // Should the weak pull-ups be activated?
    if ( eeprom_read( VSCP_EEPROM_END + REG0_BEIJING_MODULE_CTRL ) & MODULE_CTRL_PULLUP ) {
        INTCON2bits.RBPU = 0;
    }

    dir = ( eeprom_read( VSCP_EEPROM_END + REG0_BEIJING_IO_DIRECTION_LSB ) << 1 ) & 0b11111000;
    TRISC = dir | 0b00000001;
    
    memset( debounce_cnt, 0, sizeof( debounce_cnt ) );
    memset( event_sent, 0, sizeof( event_sent ) );
    current_channel_to_check = 0;   // Check debounce on channel 0
    
    // Save the current I/O state
    current_iostate = ( CHANNEL9 << 9 ) +
                        ( CHANNEL8 << 8 ) +
                        ( CHANNEL7 << 7 ) +
                        ( CHANNEL6 << 6 ) +
                        ( CHANNEL5 << 5 ) +
                        ( CHANNEL4 << 4 ) +
                        ( CHANNEL3 << 3 ) +
                        ( CHANNEL2 << 2 ) +
                        ( CHANNEL1 << 1 ) +
                        CHANNEL0;
}


///////////////////////////////////////////////////////////////////////////////
// init_app_eeprom
//

void init_app_eeprom(void)
{
    unsigned char i, j;

    eeprom_write( VSCP_EEPROM_END + REG0_BEIJING_ZONE, 0 );
    eeprom_write( VSCP_EEPROM_END + REG0_BEIJING_SUBZONE, 0 );
    
    for ( i=0; i<10; i++ ) {
        eeprom_write( VSCP_EEPROM_END + REG0_BEIJING_CH0_SUBZONE + i, i );
    }
    
    eeprom_write( VSCP_EEPROM_END + REG0_BEIJING_IO_DIRECTION_MSB, CHANNEL_DEFAULT_DIRECTION_MSB );
    eeprom_write( VSCP_EEPROM_END + REG0_BEIJING_IO_DIRECTION_LSB, CHANNEL_DEFAULT_DIRECTION_LSB );

    for ( i=0; i<10; i++ ) {
        eeprom_write( VSCP_EEPROM_END + REG0_BEIJING_CH0_OUTPUT_CTRL + i,
                        OUTPUT_CTRL_ONEVENT |
                        OUTPUT_CTRL_OFFEVENT |
                        OUTPUT_CTRL_ENABLED );
    }
    
    for ( i=0; i<10; i++ ) {
        eeprom_write( VSCP_EEPROM_END + REG0_BEIJING_CH0_INPUT_CTRL + i,
                        INPUT_CTRL_EVENT_ON |
                        INPUT_CTRL_EVENT_OFF |
                        INPUT_CTRL_ENABLE );
    }
    
    eeprom_write( VSCP_EEPROM_END + REG0_BEIJING_MODULE_CTRL, 0 );
    
    eeprom_write( VSCP_EEPROM_END + REG0_BEIJING_STREAM_TIMING, 0 );
    
    for ( i=0; i<20; i++ ) {
        eeprom_write( VSCP_EEPROM_END + 
                        REG0_COUNT +  // needed for page 1
                        REG1_BEIJING_CH0_TIMING_PULSE_MSB + i, 0 );
    }

    for ( i=0; i<20; i++ ) {
        eeprom_write( VSCP_EEPROM_END + 
                        REG0_COUNT +  // needed for page 1
                        REG1_BEIJING_CH0_TIMING_PROTECT_MSB + i, 0 );
    }
    
    // Debounce counter
    eeprom_write( VSCP_EEPROM_END + REG0_BEIJING_DEBOUNCE_COUNT, 
                    DEBOUNCE_COUNT_DEFAULT );
    
    // Short pulse
    eeprom_write( VSCP_EEPROM_END + REG0_BEIJING_SHORT_PULSE_TIME, SHORT_PULSE_DEFAULT );

    // * * * Decision Matrix * * *
    // All elements disabled.
    for ( i = 0; i < DESCION_MATRIX_ROWS; i++ ) {
        for ( j = 0; j < 8; j++ ) {
            eeprom_write( VSCP_EEPROM_END + 
                            REG0_COUNT + REG1_COUNT +
                            REG_DESCION_MATRIX + i * 8 + j, 0 );
        }
    }
    
    // Calculate dynamic filter
    calculateSetFilterMask();

}

///////////////////////////////////////////////////////////////////////////////
// doApplicationOneSecondWork
//

void doApplicationOneSecondWork(void)
{

    uint8_t i;
    uint16_t iodirections;  // Directions fro I/O channels
    uint8_t ctrlreg;        // Control register
    BOOL bOn = FALSE;
    BOOL bInput;            // State of input

    // Get direction for channels
    iodirections = ( eeprom_read( VSCP_EEPROM_END + REG0_BEIJING_IO_DIRECTION_MSB ) << 8 ) +
                    eeprom_read( VSCP_EEPROM_END + REG0_BEIJING_IO_DIRECTION_LSB );
    
    for ( i = 0; i < 10; i++ ) {
        
        if (  iodirections & ( 1 << i ) ) {
            
            // * * * Input * * *
            
            // Get input control register for this channel
            ctrlreg = eeprom_read( VSCP_EEPROM_END + REG0_BEIJING_CH0_INPUT_CTRL + i );
            
            // If not enabled check next
            if ( !( ctrlreg & INPUT_CTRL_ENABLE ) ) continue;
            
            switch ( i ) {
                    
                case 0:
                    bInput = CHANNEL0;
                    break;
                        
                case 1:
                    bInput = CHANNEL1;
                    break;
                        
                case 2:
                    bInput = CHANNEL2;
                    break;
                        
                case 3:
                    bInput = CHANNEL3;
                    break;

                case 4:
                    bInput = CHANNEL4;
                    break;

                case 5:
                    bInput = CHANNEL5;
                    break;

                case 6:
                    bInput = CHANNEL6;
                    break;

                case 7:
                    bInput = CHANNEL7;
                    break;

                case 8:
                    bInput = CHANNEL8;
                    break;

                case 9:
                    bInput = CHANNEL9;
                    break;                        
                }
            
            // Should change ON event be sent?
            if (  ctrlreg & INPUT_CTRL_EVENT_ON ) {
                                
                if ( bInput ) {
                    
                    // Yes if last state was zero
                    if ( !( current_iostate & ( 1 << i ) ) ) {
                        
                        if ( ctrlreg &  INPUT_CTRL_EVENT_SELECT ) {
                            SendInformationEvent( i, 
                                                    VSCP_CLASS1_CONTROL,
                                                    VSCP_TYPE_CONTROL_TURNON );
                        }   
                        else {
                            SendInformationEvent( i, 
                                                    VSCP_CLASS1_INFORMATION,
                                                    VSCP_TYPE_INFORMATION_ON );
                        }
                        
                    }
                }
            }
            
            // Should change OFF event be sent?
            if (  ctrlreg & INPUT_CTRL_EVENT_OFF ) {
                
                if ( !bInput ) {
                    
                    // Yes if last state was one
                    if ( current_iostate & ( 1 << i ) ) {
                        if ( ctrlreg &  INPUT_CTRL_EVENT_SELECT ) {
                            SendInformationEvent( i, 
                                                    VSCP_CLASS1_CONTROL,
                                                    VSCP_TYPE_CONTROL_TURNOFF );
                        }
                        else {
                            SendInformationEvent( i, 
                                                    VSCP_CLASS1_INFORMATION,
                                                    VSCP_TYPE_INFORMATION_OFF );
                        }
                    }
                }
            }
            
            // Should alarm high event be sent?
            if ( ctrlreg & INPUT_CTRL_ALARM_HIGH ) {
                
                if ( bInput ) {
                    
                    // Yes if last state was zero
                    if ( !( current_iostate & ( 1 << i ) ) || 
                            ( ctrlreg & INPUT_CTRL_ALARM_CONTINIOUS ) ) {
                        SendInformationEvent( i, 
                                                VSCP_CLASS1_ALARM,
                                                VSCP_TYPE_ALARM_ALARM );
                        vscp_alarmstatus |= ALARM_INPUT_HIGH;
                    }
                    
                }
                
            }
            
            // Should alarm low event be sent?
            if ( ctrlreg & INPUT_CTRL_ALARM_LOW ) {
                
                if (!bInput ) {
                    
                    // Yes if last state was one
                    if ( current_iostate & ( 1 << i ) ||
                            ( ctrlreg & INPUT_CTRL_ALARM_CONTINIOUS ) ) {
                        SendInformationEvent( i, 
                                                VSCP_CLASS1_ALARM,
                                                VSCP_TYPE_ALARM_ALARM );
                        vscp_alarmstatus |= ALARM_INPUT_LOW;
                    }
                    
                }
                
            }
            
        }
        else {
            
            // * * * Output * * *
            
            // Get output control register for this channel
            ctrlreg = eeprom_read( VSCP_EEPROM_END + REG0_BEIJING_CH0_OUTPUT_CTRL + i );

            // If not enabled check next
            if ( !( ctrlreg & OUTPUT_CTRL_ENABLED ) ) continue;

            // * * * Protection timer * * *

            if ( channel_protection_timer[ i ] ) {

                channel_protection_timer[ i ]--;

                // Check if its time to act on protection time
                if (!channel_protection_timer[ i ] &&
                        ( eeprom_read(VSCP_EEPROM_END + REG0_BEIJING_CH0_OUTPUT_CTRL + i ) &
                        OUTPUT_CTRL_PROTECTION ) ) {

                    // Yes - its time to protect this channel
                    doActionOff(0, (1 << i));

                    // Should alarm be sent?
                    if (ctrlreg & OUTPUT_CTRL_ALARM) {
                        SendInformationEvent( i, 
                                                VSCP_CLASS1_ALARM,
                                                VSCP_TYPE_ALARM_ALARM);
                    }
                    
                    vscp_alarmstatus |= ALARM_STATE_PROTECTION;

                }
            } 
            else {
                // Reload protection timer
                channel_protection_timer[ i ] =
                        eeprom_read(VSCP_EEPROM_END + REG0_COUNT +
                                    REG1_BEIJING_CH0_TIMING_PROTECT_MSB + i) * 256 +
                                    eeprom_read(VSCP_EEPROM_END + REG0_COUNT +
                                    REG1_BEIJING_CH0_TIMING_PROTECT_LSB + i);
            }

            // * * * Pulsed channels * * *
            if ( channel_pulse_flags & (1 << i) ) {

                if ( channel_pulse_timer[ i ] ) {

                    channel_pulse_timer[ i ]--;

                    // If zero its time for state change
                    if ( !channel_pulse_timer[ i ] ) {

                        switch (i) {

                            case 0:
                                if ( CHANNEL0 ) {
                                    CHANNEL0 = 0;
                                    bOn = FALSE;
                                } 
                                else {
                                    CHANNEL0 = 1;
                                    bOn = TRUE;
                                }
                                break;

                            case 1:
                                if ( CHANNEL1 ) {
                                    CHANNEL1 = 0;
                                    bOn = FALSE;
                                } 
                                else {
                                    CHANNEL1 = 1;
                                    bOn = TRUE;
                                }
                                break;

                            case 2:
                                if ( CHANNEL2 ) {
                                    CHANNEL2 = 0;
                                    bOn = FALSE;
                                } 
                                else {
                                    CHANNEL2 = 1;
                                    bOn = TRUE;
                                }
                                break;

                            case 3:
                                if ( CHANNEL3 ) {
                                    CHANNEL3 = 0;
                                    bOn = FALSE;
                                } 
                                else {
                                    CHANNEL3 = 1;
                                    bOn = TRUE;
                                }
                                break;

                            case 4:
                                if ( CHANNEL4 ) {
                                    CHANNEL4 = 0;
                                    bOn = FALSE;
                                } 
                                else {
                                    CHANNEL4 = 1;
                                    bOn = TRUE;
                                }
                                break;

                            case 5:
                                if ( CHANNEL5 ) {
                                    CHANNEL5 = 0;
                                    bOn = FALSE;
                                } 
                                else {
                                    CHANNEL5 = 1;
                                    bOn = TRUE;
                                }
                                break;

                            case 6:
                                if ( CHANNEL6 ) {
                                    CHANNEL6 = 0;
                                    bOn = FALSE;
                                } 
                                else {
                                    CHANNEL6 = 1;
                                    bOn = TRUE;
                                }
                                break;
                               
                            case 7:
                                if ( CHANNEL7 ) {
                                    CHANNEL7 = 0;
                                    bOn = FALSE;
                                } 
                                else {
                                    CHANNEL7 = 1;
                                    bOn = TRUE;
                                }
                                break;
                                
                            case 8:
                                if ( CHANNEL8 ) {
                                    CHANNEL8 = 0;
                                    bOn = FALSE;
                                } 
                                else {
                                    CHANNEL8 = 1;
                                    bOn = TRUE;
                                }
                                break;
                                
                            case 9:
                                if ( CHANNEL9 ) {
                                    CHANNEL9 = 0;
                                    bOn = FALSE;
                                } 
                                else {
                                    CHANNEL9 = 1;
                                    bOn = TRUE;
                                }
                                break;    
                        }

                        // Reload pulse timer
                        channel_pulse_timer[ i ] =
                                eeprom_read( VSCP_EEPROM_END + REG0_COUNT +
                                                REG1_BEIJING_CH0_TIMING_PULSE_MSB + 2 * i ) * 256 +
                                                eeprom_read( VSCP_EEPROM_END + REG0_COUNT +
                                                REG1_BEIJING_CH0_TIMING_PULSE_MSB + 2 * i );

                        if ( bOn ) {

                            // Reload protection timer
                            if ( eeprom_read(VSCP_EEPROM_END + REG0_BEIJING_CH0_OUTPUT_CTRL + i) & 
                                                OUTPUT_CTRL_PROTECTION) {
                                channel_protection_timer[ i ] =
                                        eeprom_read( VSCP_EEPROM_END + REG0_COUNT +
                                                        REG1_BEIJING_CH0_TIMING_PROTECT_MSB + 2 * i) * 256 +
                                                        eeprom_read(VSCP_EEPROM_END + REG0_COUNT +
                                                        REG1_BEIJING_CH0_TIMING_PROTECT_LSB + 2 * i);
                            }

                            if ( ctrlreg & OUTPUT_CTRL_ONEVENT ) {
                                SendInformationEvent( i, 
                                                        VSCP_CLASS1_INFORMATION,
                                                        VSCP_TYPE_INFORMATION_ON);
                            }


                        } 
                        else {

                            if ( ctrlreg & OUTPUT_CTRL_OFFEVENT ) {
                                SendInformationEvent( i, VSCP_CLASS1_INFORMATION,
                                                        VSCP_TYPE_INFORMATION_OFF);
                            }

                        }

                    } // State change

                } // Something to count down
                else {
                    // Reload the pulse timer
                    channel_pulse_timer[ i ] =
                            eeprom_read(VSCP_EEPROM_END + REG0_COUNT +
                                        REG1_BEIJING_CH0_TIMING_PULSE_MSB + 2 * i) * 256 +
                                        eeprom_read(VSCP_EEPROM_END + REG0_COUNT +
                                        REG1_BEIJING_CH0_TIMING_PULSE_LSB + 2 * i);
                }

            } // Pulse bit

        }

    } // for all channels
    
    
    // Check if stream event should be sent
    if ( eeprom_read(VSCP_EEPROM_END + REG0_BEIJING_STREAM_TIMING ) ) {
    
        uint8_t data[ 3 ]; 
        
        data[ 0 ] = 0;  // Data coding (coding=0(bits), unit=0, sensor=0)
        data[ 1 ] = ( CHANNEL9 << 1 ) + 
                        CHANNEL8;
        data[ 2 ] = ( CHANNEL7 << 7 ) + 
                        ( CHANNEL6 << 6 ) +
                        ( CHANNEL5 << 5 ) +
                        ( CHANNEL4 << 4 ) +
                        ( CHANNEL3 << 3 ) +
                        ( CHANNEL2 << 2 ) +
                        ( CHANNEL1 << 1 ) +
                        CHANNEL0;

        // Send event
        sendVSCPFrame( VSCP_CLASS1_DATA,
                        VSCP_TYPE_DATA_IO,
                        vscp_nickname,
                        VSCP_PRIORITY_MEDIUM,
                        3,
                        data );
    }
    
    // Save the current I/O state
    current_iostate = ( CHANNEL9 << 9 ) +
                        ( CHANNEL8 << 8 ) +
                        ( CHANNEL7 << 7 ) +
                        ( CHANNEL6 << 6 ) +
                        ( CHANNEL5 << 5 ) +
                        ( CHANNEL4 << 4 ) +
                        ( CHANNEL3 << 3 ) +
                        ( CHANNEL2 << 2 ) +
                        ( CHANNEL1 << 1 ) +
                        CHANNEL0;
}

///////////////////////////////////////////////////////////////////////////////
// Get Major version number for this hardware module
//

unsigned char getMajorVersion()
{
    return FIRMWARE_MAJOR_VERSION;
}

///////////////////////////////////////////////////////////////////////////////
// Get Minor version number for this hardware module
//

unsigned char getMinorVersion()
{
    return FIRMWARE_MINOR_VERSION;
}

///////////////////////////////////////////////////////////////////////////////
// Get Subminor version number for this hardware module
//

unsigned char getSubMinorVersion()
{
    return FIRMWARE_SUB_MINOR_VERSION;
}

///////////////////////////////////////////////////////////////////////////////
// Get GUID from EEPROM
//

#ifdef ENABLE_WRITE_2PROTECTED_LOCATIONS

void vscp_setGUID(uint8_t idx, uint8_t data ) {
    if ( idx>15 ) return;
    eeprom_write(VSCP_EEPROM_REG_GUID + idx, data);
}
#endif

///////////////////////////////////////////////////////////////////////////////
// Get Manufacturer id and subid from EEPROM
//

#ifdef ENABLE_WRITE_2PROTECTED_LOCATIONS

void vscp_setManufacturerId( uint8_t idx, uint8_t data ) {
    if ( idx>7 ) return;
    eeprom_write(VSCP_EEPROM_REG_MANUFACTUR_ID0 + idx, data);
}
#endif

///////////////////////////////////////////////////////////////////////////////
// Get the bootloader algorithm code
//

unsigned char getBootLoaderAlgorithm(void)
{
    return VSCP_BOOTLOADER_PIC1;
}

///////////////////////////////////////////////////////////////////////////////
// Get the buffer size
//

unsigned char getBufferSize(void)
{
    return 8; // Standard CAN frame
}

///////////////////////////////////////////////////////////////////////////////
//  vscp_readNicknamePermanent
//

uint8_t vscp_readNicknamePermanent(void)
{
    return eeprom_read( VSCP_EEPROM_NICKNAME );
}

///////////////////////////////////////////////////////////////////////////////
//  vscp_writeNicknamePermanent
//

void vscp_writeNicknamePermanent(uint8_t nickname)
{
    eeprom_write( VSCP_EEPROM_NICKNAME, nickname );
}

///////////////////////////////////////////////////////////////////////////////
// vscp_getZone
//

uint8_t vscp_getZone(void)
{
    return eeprom_read( VSCP_EEPROM_END + REG0_BEIJING_ZONE );
}

///////////////////////////////////////////////////////////////////////////////
// vscp_getSubzone
//

uint8_t vscp_getSubzone(void)
{
    return eeprom_read( VSCP_EEPROM_END + REG0_BEIJING_SUBZONE );
}

///////////////////////////////////////////////////////////////////////////////
// doWork
//
// The actual work is done here.
//

void doWork(void)
{
    if ( VSCP_STATE_ACTIVE == vscp_node_state ) {
		;
    }
}

///////////////////////////////////////////////////////////////////////////////
// vscp_readAppReg
//

uint8_t vscp_readAppReg(uint8_t reg)
{    
    uint8_t rv;

    rv = 0x00; // default read
    
    // * * *  Page 0  * * *
    if ( 0 == vscp_page_select ) {

        // Zone
        if ( reg == REG0_BEIJING_ZONE ) {
            rv = eeprom_read( VSCP_EEPROM_END + REG0_BEIJING_ZONE );
        }            // SubZone
        else if ( reg == REG0_BEIJING_SUBZONE ) {
            rv = eeprom_read( VSCP_EEPROM_END + REG0_BEIJING_SUBZONE );
        }
        else if ( ( reg >= REG0_BEIJING_CH0_SUBZONE ) && 
                    ( reg <= REG0_BEIJING_CH9_SUBZONE ) ) {
            rv = eeprom_read( VSCP_EEPROM_END + 
                                REG0_BEIJING_CH0_SUBZONE + 
                                ( reg - REG0_BEIJING_CH0_SUBZONE ) );
        }
        else if ( reg == REG0_BEIJING_IO_DIRECTION_MSB ) {
            rv = ( TRISAbits.TRISA0 << 1 ) +
                    TRISAbits.TRISA1;
        }
        else if ( reg == REG0_BEIJING_IO_DIRECTION_LSB ) {
            rv = ( TRISAbits.TRISA2 << 7 ) +
                    ( TRISCbits.TRISC7 << 6 ) +
                    ( TRISCbits.TRISC6 << 5 ) +
                    ( TRISCbits.TRISC5 << 4 ) +
                    ( TRISCbits.TRISC4 << 3 ) +
                    ( TRISCbits.TRISC3 << 2 ) +
                    ( TRISBbits.TRISB1 << 1 ) +
                    TRISBbits.TRISB0;
        }
        else if ( ( reg >= REG0_BEIJING_CH0_STATUS ) &&
                ( reg <= REG0_BEIJING_CH9_STATUS ) ) {

            switch ( reg ) {

                    // Channel 0 Status
                case REG0_BEIJING_CH0_STATUS:
                    rv = CHANNEL0;
                    break;

                    // Channel 1 Status
                case REG0_BEIJING_CH1_STATUS:
                    rv = CHANNEL1;
                    break;

                    // Channel 2 Status
                case REG0_BEIJING_CH2_STATUS:
                    rv = CHANNEL2;
                    break;

                    // Channel 3 Status
                case REG0_BEIJING_CH3_STATUS:
                    rv = CHANNEL3;
                    break;

                    // Channel 4 Status
                case REG0_BEIJING_CH4_STATUS:
                    rv = CHANNEL4;
                    break;

                    // Channel 5 Status
                case REG0_BEIJING_CH5_STATUS:
                    rv = CHANNEL5;
                    break;

                    // Channel 6 Status
                case REG0_BEIJING_CH6_STATUS:
                    rv = CHANNEL6;
                    break;

                    // Channel 7 Status
                case REG0_BEIJING_CH7_STATUS:
                    rv = CHANNEL7;
                    break;

                    // Channel 8 Status
                case REG0_BEIJING_CH8_STATUS:
                    rv = CHANNEL8;
                    break;

                    // Channel 9 Status
                case REG0_BEIJING_CH9_STATUS:
                    rv = CHANNEL9;
                    break;
            }
        }
        // Read all other registers
        else if ( ( reg >= REG0_BEIJING_CH0_OUTPUT_CTRL ) &&
                ( reg < REG0_COUNT ) ) {
            rv = eeprom_read( VSCP_EEPROM_END + reg );
        }
        
    } // page 0
    
    // * * *  Page 1  * * *
    else if ( 1 == vscp_page_select ) {
        if ( reg < REG1_COUNT ) {
            rv = eeprom_read( VSCP_EEPROM_END + REG0_COUNT + reg );
        }
    }
    // * * *  Page 2  * * *
    else if ( 2 == vscp_page_select ) {
        if ( reg < ( REG_DESCION_MATRIX + 8*DESCION_MATRIX_ROWS ) ) {
            rv = eeprom_read( VSCP_EEPROM_END + 
                                REG_DESCION_MATRIX + 
                                REG0_COUNT + 
                                REG1_COUNT + 
                                reg );
        }
    }
    
    return rv;

}

///////////////////////////////////////////////////////////////////////////////
// vscp_writeAppReg
//

uint8_t vscp_writeAppReg( uint8_t reg, uint8_t val )
{
    uint8_t rv;
    BOOL bInfoEvent = FALSE;
    BOOL bOn = FALSE;

    rv = ~val; // error return
    
    // * * *  Page 0  * * *
    if ( 0 == vscp_page_select ) {

        // Zone
        if ( reg == REG0_BEIJING_ZONE ) {
            eeprom_write(VSCP_EEPROM_END + REG0_BEIJING_ZONE, val);
            rv = eeprom_read(VSCP_EEPROM_END + REG0_BEIJING_ZONE);
        }
        else if ( reg == REG0_BEIJING_SUBZONE ) {
            // SubZone
            eeprom_write(VSCP_EEPROM_END + REG0_BEIJING_SUBZONE, val);
            rv = eeprom_read(VSCP_EEPROM_END + REG0_BEIJING_SUBZONE);
        }
        // Channel sub zones
        else if ( ( reg >= REG0_BEIJING_CH0_SUBZONE ) && 
                       ( reg <= REG0_BEIJING_CH9_SUBZONE ) ) {
            eeprom_write( VSCP_EEPROM_END + 
                                REG0_BEIJING_CH0_SUBZONE + 
                                ( reg - REG0_BEIJING_CH0_SUBZONE ), val );
            rv = eeprom_read( VSCP_EEPROM_END + 
                                REG0_BEIJING_CH0_SUBZONE + 
                                ( reg - REG0_BEIJING_CH0_SUBZONE ) );
        }
        else if ( reg == REG0_BEIJING_IO_DIRECTION_MSB ) {
            
            eeprom_write( VSCP_EEPROM_END + REG0_BEIJING_IO_DIRECTION_MSB,
                            ( val & 0x03 ) );
            
            TRISAbits.TRISA0 = ( val & 0x02 ) ? 1 : 0;
            TRISAbits.TRISA1 = ( val & 0x01 ) ? 1 : 0;
            
            rv = ( TRISAbits.TRISA0 << 1 ) + TRISAbits.TRISA1;
        }
        else if ( reg == REG0_BEIJING_IO_DIRECTION_LSB ) {
            
            eeprom_write( VSCP_EEPROM_END + 
                                    REG0_BEIJING_IO_DIRECTION_LSB,
                                    val);
            
            TRISAbits.TRISA2 = ( val & 0x80 ) ? 1 : 0;
            TRISCbits.TRISC7 = ( val & 0x40 ) ? 1 : 0;
            TRISCbits.TRISC6 = ( val & 0x20 ) ? 1 : 0;
            TRISCbits.TRISC5 = ( val & 0x10 ) ? 1 : 0;
            TRISCbits.TRISC4 = ( val & 0x08 ) ? 1 : 0;
            TRISCbits.TRISC3 = ( val & 0x04 ) ? 1 : 0;
            TRISBbits.TRISB1 = ( val & 0x02 ) ? 1 : 0;
            TRISBbits.TRISB0 = ( val & 0x01 ) ? 1 : 0;
            
            rv = ( TRISAbits.TRISA2 << 7 ) +
                    ( TRISCbits.TRISC7 << 6 ) +
                    ( TRISCbits.TRISC6 << 5 ) +
                    ( TRISCbits.TRISC5 << 4 ) +
                    ( TRISCbits.TRISC4 << 3 ) +
                    ( TRISCbits.TRISC3 << 2 ) +
                    ( TRISBbits.TRISB1 << 1 ) +
                    TRISBbits.TRISB0;
            
        }
        // Channel Status registers?
        else if ( (reg >= REG0_BEIJING_CH0_STATUS) && (reg <= REG0_BEIJING_CH9_STATUS) ) {

            // If enabled
            if ( eeprom_read( VSCP_EEPROM_END +
                                REG0_BEIJING_CH0_OUTPUT_CTRL + 
                                ( reg - REG0_BEIJING_CH0_STATUS ) ) &
                                OUTPUT_CTRL_ENABLED ) {

                switch ( reg ) {

                    // Channel 0 State
                    case REG0_BEIJING_CH0_STATUS:
                    
                        bInfoEvent = TRUE;

                        if ( 1 == val ) {
                            
                            CHANNEL0 = 1;
                            rv = CHANNEL0;
                            bOn = TRUE;

                            // If needed - Update protection timer
                            if ( eeprom_read( VSCP_EEPROM_END + REG0_BEIJING_CH0_OUTPUT_CTRL ) & OUTPUT_CTRL_PROTECTION ) {
                                channel_protection_timer[ 0 ] =
                                    eeprom_read( VSCP_EEPROM_END + REG0_COUNT +
                                                    REG1_BEIJING_CH0_TIMING_PROTECT_MSB ) * 256 +
                                    eeprom_read( VSCP_EEPROM_END + REG0_COUNT +
                                                    REG1_BEIJING_CH0_TIMING_PROTECT_LSB );
                            }

                        }
                        else if (0 == val) {
                            CHANNEL0 = 0;
                            rv = CHANNEL0;
                            bOn = FALSE;
                        }
                        break;

                    // Channel 1 State
                    case REG0_BEIJING_CH1_STATUS:

                        bInfoEvent = TRUE;

                        if (1 == val) {

                            CHANNEL1 = 1;
                            rv = CHANNEL1;
                            bOn = TRUE;

                            if (eeprom_read(VSCP_EEPROM_END + REG0_BEIJING_CH1_OUTPUT_CTRL) & OUTPUT_CTRL_PROTECTION) {
                                channel_protection_timer[ 1 ] =
                                    eeprom_read(VSCP_EEPROM_END + REG0_COUNT +
                                                REG1_BEIJING_CH1_TIMING_PROTECT_MSB) * 256 +
                                    eeprom_read(VSCP_EEPROM_END + REG0_COUNT +
                                                REG1_BEIJING_CH1_TIMING_PROTECT_LSB);
                            }

                        }
                        else if (0 == val) {
                            CHANNEL1 = 0;
                            rv = CHANNEL1;
                            bOn = FALSE;
                        }
                        break;

                    // Channel 2 State
                    case REG0_BEIJING_CH2_STATUS:

                        bInfoEvent = TRUE;

                        if (1 == val) {

                            CHANNEL2 = 1;
                            rv = CHANNEL2;
                            bOn = TRUE;

                            if ( eeprom_read(VSCP_EEPROM_END + REG0_BEIJING_CH2_OUTPUT_CTRL) & OUTPUT_CTRL_PROTECTION) {
                                channel_protection_timer[ 2 ] =
                                    eeprom_read(VSCP_EEPROM_END + REG0_COUNT +
                                                REG1_BEIJING_CH2_TIMING_PROTECT_MSB) * 256 +
                                    eeprom_read(VSCP_EEPROM_END + REG0_COUNT +
                                                REG1_BEIJING_CH2_TIMING_PROTECT_LSB);
                            }

                        }
                        else if (0 == val) {
                            CHANNEL2 = 0;
                            rv = CHANNEL2;
                            bOn = FALSE;

                        }
                        break;

                    // Channel 3 State
                    case REG0_BEIJING_CH3_STATUS:

                        bInfoEvent = TRUE;

                        if (1 == val) {

                            CHANNEL3 = 1;
                            rv = CHANNEL3;
                            bOn = TRUE;

                            if (eeprom_read(VSCP_EEPROM_END + REG0_BEIJING_CH3_OUTPUT_CTRL) & OUTPUT_CTRL_PROTECTION) {
                                channel_protection_timer[ 3 ] =
                                    eeprom_read(VSCP_EEPROM_END + REG0_COUNT +
                                                REG1_BEIJING_CH3_TIMING_PROTECT_MSB) * 256 +
                                    eeprom_read(VSCP_EEPROM_END + REG0_COUNT +
                                                REG1_BEIJING_CH3_TIMING_PROTECT_LSB);
                            }

                        }
                        else if (0 == val) {
                            CHANNEL3 = 0;
                            rv = CHANNEL3;
                            bOn = FALSE;

                        }
                        break;

                    // Channel 4 State
                    case REG0_BEIJING_CH4_STATUS:

                        bInfoEvent = TRUE;

                        if (1 == val) {

                            CHANNEL4 = 1;
                            rv = CHANNEL4;
                            bOn = TRUE;

                            if (eeprom_read(VSCP_EEPROM_END + REG0_BEIJING_CH4_OUTPUT_CTRL) & OUTPUT_CTRL_PROTECTION) {
                                channel_protection_timer[ 4 ] =
                                    eeprom_read(VSCP_EEPROM_END + REG0_COUNT +
                                                REG1_BEIJING_CH4_TIMING_PROTECT_MSB) * 256 +
                                    eeprom_read(VSCP_EEPROM_END + REG0_COUNT +
                                                REG1_BEIJING_CH4_TIMING_PROTECT_LSB);
                            }

                        }
                        else if (0 == val) {
                            CHANNEL4 = 0;
                            rv = CHANNEL4;
                            bOn = FALSE;

                        }
                        break;

                    // Channel 5 State
                    case REG0_BEIJING_CH5_STATUS:

                        bInfoEvent = TRUE;

                        if (1 == val) {

                            CHANNEL5 = 1;
                            rv = CHANNEL5;
                            bOn = TRUE;

                            if (eeprom_read(VSCP_EEPROM_END + REG0_BEIJING_CH5_OUTPUT_CTRL) & OUTPUT_CTRL_PROTECTION) {
                                channel_protection_timer[ 5 ] =
                                    eeprom_read(VSCP_EEPROM_END + REG0_COUNT +
                                                REG1_BEIJING_CH5_TIMING_PROTECT_MSB) * 256 +
                                    eeprom_read(VSCP_EEPROM_END + REG0_COUNT +
                                                REG1_BEIJING_CH5_TIMING_PROTECT_LSB);
                            }

                        }
                        else if (0 == val) {
                            CHANNEL5 = 0;
                            rv = CHANNEL5;
                            bOn = FALSE;
                        }
                        break;

                    // Channel 6 State
                    case REG0_BEIJING_CH6_STATUS:

                        bInfoEvent = TRUE;

                        if (1 == val) {
                        
                            CHANNEL6 = 1;
                            rv = CHANNEL6;
                            bOn = TRUE;

                            if (eeprom_read(VSCP_EEPROM_END + REG0_BEIJING_CH6_OUTPUT_CTRL) & OUTPUT_CTRL_PROTECTION) {
                                channel_protection_timer[ 6 ] =
                                    eeprom_read(VSCP_EEPROM_END + REG0_COUNT +
                                                REG1_BEIJING_CH6_TIMING_PROTECT_MSB) * 256 +
                                    eeprom_read(VSCP_EEPROM_END + REG0_COUNT +
                                                REG1_BEIJING_CH6_TIMING_PROTECT_LSB);
                            }

                        }
                        else if (0 == val) {
                            CHANNEL6 = 0;
                            rv = CHANNEL6;
                            bOn = FALSE;
                        }
                        break;

                    // Channel 7 State
                    case REG0_BEIJING_CH7_STATUS:

                        bInfoEvent = TRUE;

                        if (1 == val) {
                        
                            CHANNEL7 = 1;
                            rv = CHANNEL7;
                            bOn = TRUE;

                            if (eeprom_read(VSCP_EEPROM_END + REG0_BEIJING_CH7_OUTPUT_CTRL) & OUTPUT_CTRL_PROTECTION) {
                                channel_protection_timer[ 7 ] =
                                    eeprom_read(VSCP_EEPROM_END + REG0_COUNT +
                                                REG1_BEIJING_CH7_TIMING_PROTECT_MSB) * 256 +
                                    eeprom_read(VSCP_EEPROM_END + REG0_COUNT +
                                                REG1_BEIJING_CH7_TIMING_PROTECT_LSB);
                            }

                        }
                        else if (0 == val) {
                            CHANNEL7 = 0;
                            rv = CHANNEL7;
                            bOn = FALSE;
                        }
                        break;
                    
                    // Channel 8 State
                    case REG0_BEIJING_CH8_STATUS:

                        bInfoEvent = TRUE;

                        if (1 == val) {
                        
                            CHANNEL8 = 1;
                            rv = CHANNEL8;
                            bOn = TRUE;

                            if ( eeprom_read( VSCP_EEPROM_END + REG0_BEIJING_CH8_OUTPUT_CTRL ) & OUTPUT_CTRL_PROTECTION ) {
                                channel_protection_timer[ 8 ] =
                                    eeprom_read(VSCP_EEPROM_END + REG0_COUNT +
                                                REG1_BEIJING_CH8_TIMING_PROTECT_MSB) * 256 +
                                    eeprom_read(VSCP_EEPROM_END + REG0_COUNT +
                                                REG1_BEIJING_CH8_TIMING_PROTECT_LSB);
                            }

                        }
                        else if ( 0 == val ) {
                            CHANNEL8 = 0;
                            rv = CHANNEL8;
                            bOn = FALSE;
                        }
                        break;
    
                    // Channel 9 State
                    case REG0_BEIJING_CH9_STATUS:

                        bInfoEvent = TRUE;

                        if ( 1 == val ) {
                        
                            CHANNEL9 = 1;
                            rv = CHANNEL9;
                            bOn = TRUE;

                            if ( eeprom_read( VSCP_EEPROM_END + REG0_BEIJING_CH9_OUTPUT_CTRL ) & OUTPUT_CTRL_PROTECTION ) {
                                channel_protection_timer[ 9 ] =
                                    eeprom_read( VSCP_EEPROM_END + REG0_COUNT +
                                                REG1_BEIJING_CH9_TIMING_PROTECT_MSB ) * 256 +
                                    eeprom_read( VSCP_EEPROM_END + REG0_COUNT +
                                                REG1_BEIJING_CH9_TIMING_PROTECT_LSB );
                            }

                        }
                        else if ( 0 == val ) {
                            CHANNEL9 = 0;
                            rv = CHANNEL9;
                            bOn = FALSE;
                        }
                        break;

                }
            }
        }

        // Output control registers
        else if ( (reg >= REG0_BEIJING_CH0_OUTPUT_CTRL ) &&
                    (reg <= REG0_BEIJING_CH9_OUTPUT_CTRL) ) {

            switch( reg ) {

                case REG0_BEIJING_CH0_OUTPUT_CTRL:

                    eeprom_write( VSCP_EEPROM_END + reg, val );
                    rv = eeprom_read( VSCP_EEPROM_END + reg );

                    if ( val & OUTPUT_CTRL_PULSE ) {

                        CHANNEL0 = 0; // Start out at a known state
                        bOn = FALSE;

                        channel_pulse_flags |= 0b0000000001; // Enable pulse output
                        channel_pulse_timer[ 0 ] =
                                    eeprom_read( VSCP_EEPROM_END + REG0_COUNT +
                                                    REG1_BEIJING_CH0_TIMING_PULSE_MSB ) * 256 +
                                    eeprom_read( VSCP_EEPROM_END + REG0_COUNT +
                                                    REG1_BEIJING_CH0_TIMING_PULSE_MSB );
                    }
                    else {
                        channel_pulse_flags &= 0b1111111110; // Disable pulse output
                        CHANNEL0 = 0; // End with off
                        bOn = FALSE;
                    }

                    if ( val & OUTPUT_CTRL_PROTECTION ) {
                        channel_protection_timer[ 0 ] =
                            eeprom_read( VSCP_EEPROM_END + REG0_COUNT +
                                        REG1_BEIJING_CH0_TIMING_PROTECT_MSB ) * 256 +
                            eeprom_read( VSCP_EEPROM_END + REG0_COUNT +
                                        REG1_BEIJING_CH0_TIMING_PROTECT_LSB );
                    }
                    break;

                case REG0_BEIJING_CH1_OUTPUT_CTRL:

                    eeprom_write( VSCP_EEPROM_END + reg, val );
                    rv = eeprom_read( VSCP_EEPROM_END + reg );

                    if ( val & OUTPUT_CTRL_PULSE ) {

                        CHANNEL1 = 0; // Start out at a known state
                        bOn = FALSE;

                        channel_pulse_flags |= 0b0000000010; // Enable pulse output
                        channel_pulse_timer[ 1 ] =
                                    eeprom_read( VSCP_EEPROM_END + REG0_COUNT +
                                                    REG1_BEIJING_CH0_TIMING_PULSE_MSB) * 256 +
                                    eeprom_read( VSCP_EEPROM_END + REG0_COUNT +
                                                    REG1_BEIJING_CH0_TIMING_PULSE_LSB);
                    }
                    else {
                        channel_pulse_flags &= 0b1111111101; // Disable pulse output
                        CHANNEL1 = 0; // End with off
                        bOn = FALSE;
                    }

                    if ( val & OUTPUT_CTRL_PROTECTION ) {
                        channel_protection_timer[ 1 ] =
                            eeprom_read( VSCP_EEPROM_END + REG0_COUNT +
                                        REG1_BEIJING_CH0_TIMING_PROTECT_MSB ) * 256 +
                            eeprom_read( VSCP_EEPROM_END + REG0_COUNT +
                                        REG1_BEIJING_CH0_TIMING_PROTECT_LSB );
                    }
                    break;

                case REG0_BEIJING_CH2_OUTPUT_CTRL:

                    eeprom_write( VSCP_EEPROM_END + reg, val );
                    rv = eeprom_read( VSCP_EEPROM_END + reg );

                    if ( val & OUTPUT_CTRL_PULSE ) {

                        CHANNEL2 = 0; // Start out at a known state
                        bOn = FALSE;

                        channel_pulse_flags |= 0b0000000100; // Enable pulse output
                        channel_pulse_timer[ 2 ] =
                                    eeprom_read( VSCP_EEPROM_END + REG0_COUNT +
                                                    REG1_BEIJING_CH2_TIMING_PULSE_MSB) * 256 +
                                    eeprom_read( VSCP_EEPROM_END + REG0_COUNT +
                                                    REG1_BEIJING_CH2_TIMING_PULSE_LSB);
                    }
                    else {
                        channel_pulse_flags &= 0b1111111011; // Disable pulse output
                        CHANNEL2 = 0; // End with off
                        bOn = FALSE;
                    }

                    if ( val & OUTPUT_CTRL_PROTECTION ) {
                        channel_protection_timer[ 2 ] =
                            eeprom_read( VSCP_EEPROM_END + REG0_COUNT +
                                        REG1_BEIJING_CH2_TIMING_PROTECT_MSB ) * 256 +
                            eeprom_read( VSCP_EEPROM_END + REG0_COUNT +
                                        REG1_BEIJING_CH2_TIMING_PROTECT_LSB );
                    }
                    break;

                case REG0_BEIJING_CH3_OUTPUT_CTRL:

                    eeprom_write( VSCP_EEPROM_END + reg, val );
                    rv = eeprom_read( VSCP_EEPROM_END + reg );

                    if ( val & OUTPUT_CTRL_PULSE ) {

                        CHANNEL3 = 0; // Start out at a known state
                        bOn = FALSE;

                        channel_pulse_flags |= 0b0000001000; // Enable pulse output
                        channel_pulse_timer[ 3 ] =
                                    eeprom_read( VSCP_EEPROM_END + REG0_COUNT +
                                                    REG1_BEIJING_CH3_TIMING_PULSE_MSB ) * 256 +
                                    eeprom_read( VSCP_EEPROM_END + REG0_COUNT +
                                                    REG1_BEIJING_CH3_TIMING_PULSE_LSB );
                    }
                    else {
                        channel_pulse_flags &= 0b1111110111; // Disable pulse output
                        CHANNEL3 = 0; // End with off
                        bOn = FALSE;
                    }

                    if ( val & OUTPUT_CTRL_PROTECTION ) {
                        channel_protection_timer[ 3 ] =
                            eeprom_read( VSCP_EEPROM_END + REG0_COUNT +
                                        REG1_BEIJING_CH3_TIMING_PROTECT_MSB ) * 256 +
                            eeprom_read( VSCP_EEPROM_END + REG0_COUNT +
                                        REG1_BEIJING_CH3_TIMING_PROTECT_LSB );
                    }
                    break;

                case REG0_BEIJING_CH4_OUTPUT_CTRL:

                    eeprom_write( VSCP_EEPROM_END + reg, val );
                    rv = eeprom_read( VSCP_EEPROM_END + reg );

                    if ( val & OUTPUT_CTRL_PROTECTION ) {

                        CHANNEL4 = 0; // Start out at a known state
                        bOn = FALSE;

                        channel_pulse_flags |= 0b0000010000; // Enable pulse output
                        channel_pulse_timer[ 4 ] =
                                    eeprom_read( VSCP_EEPROM_END + REG0_COUNT +
                                                    REG1_BEIJING_CH4_TIMING_PULSE_MSB ) * 256 +
                                    eeprom_read( VSCP_EEPROM_END + REG0_COUNT +
                                                    REG1_BEIJING_CH4_TIMING_PULSE_LSB );
                    }
                    else {
                        channel_pulse_flags &= 0b1111101111; // Disable pulse output
                        CHANNEL4 = 0; // End with off
                        bOn = FALSE;
                    }

                    if ( val & OUTPUT_CTRL_PROTECTION ) {
                        channel_protection_timer[ 4 ] =
                            eeprom_read( VSCP_EEPROM_END + REG0_COUNT +
                                        REG1_BEIJING_CH4_TIMING_PROTECT_MSB ) * 256 +
                            eeprom_read( VSCP_EEPROM_END + REG0_COUNT +
                                        REG1_BEIJING_CH4_TIMING_PROTECT_LSB );
                    }
                    break;

                case REG0_BEIJING_CH5_OUTPUT_CTRL:

                    eeprom_write( VSCP_EEPROM_END + reg, val );
                    rv = eeprom_read( VSCP_EEPROM_END + reg );

                    if ( val & OUTPUT_CTRL_PULSE ) {

                        CHANNEL5 = 0; // Start out at a known state
                        bOn = FALSE;

                        channel_pulse_flags |= 0b0000100000; // Enable pulse output
                        channel_pulse_timer[ 5 ] =
                                    eeprom_read( VSCP_EEPROM_END + REG0_COUNT +
                                                    REG1_BEIJING_CH5_TIMING_PULSE_MSB) * 256 +
                                    eeprom_read( VSCP_EEPROM_END + REG0_COUNT +
                                                    REG1_BEIJING_CH5_TIMING_PULSE_LSB);
                    }
                    else {
                        channel_pulse_flags &= 0b1111011111; // Disable pulse output
                        CHANNEL5 = 0; // End with off
                        bOn = FALSE;
                    }

                    if ( val & OUTPUT_CTRL_PROTECTION ) {
                        channel_protection_timer[ 5 ] =
                            eeprom_read( VSCP_EEPROM_END + REG0_COUNT +
                                        REG1_BEIJING_CH5_TIMING_PROTECT_MSB ) * 256 +
                            eeprom_read( VSCP_EEPROM_END + REG0_COUNT +
                                        REG1_BEIJING_CH5_TIMING_PROTECT_LSB );
                    }
                    break;

                case REG0_BEIJING_CH6_OUTPUT_CTRL:

                    eeprom_write( VSCP_EEPROM_END + reg, val );
                    rv = eeprom_read( VSCP_EEPROM_END + reg );

                    if ( val & OUTPUT_CTRL_PULSE ) {
                    
                        CHANNEL6 = 0; // Start out at a known state
                        bOn = FALSE;

                        channel_pulse_flags |= 0b0001000000; // Enable pulse output
                        channel_pulse_timer[ 6 ] =
                                    eeprom_read( VSCP_EEPROM_END + REG0_COUNT +
                                                    REG1_BEIJING_CH6_TIMING_PULSE_MSB) * 256 +
                                    eeprom_read( VSCP_EEPROM_END + REG0_COUNT +
                                                    REG1_BEIJING_CH6_TIMING_PULSE_LSB);
                    }
                    else {
                        channel_pulse_flags &= 0b1110111111; // Disable pulse output
                        CHANNEL6 = 0; // End with off
                        bOn = FALSE;
                    }

                    if ( val & OUTPUT_CTRL_PROTECTION ) {
                        channel_protection_timer[ 6 ] =
                            eeprom_read( VSCP_EEPROM_END + REG0_COUNT +
                                        REG1_BEIJING_CH6_TIMING_PROTECT_MSB ) * 256 +
                            eeprom_read( VSCP_EEPROM_END + REG0_COUNT +
                                        REG1_BEIJING_CH6_TIMING_PROTECT_LSB );
                    }
                    break;
                
                case REG0_BEIJING_CH7_OUTPUT_CTRL:

                    eeprom_write( VSCP_EEPROM_END + reg, val );
                    rv = eeprom_read( VSCP_EEPROM_END + reg );

                    if ( val & OUTPUT_CTRL_PULSE ) {
                    
                        CHANNEL7 = 0; // Start out at a known state
                        bOn = FALSE;

                        channel_pulse_flags |= 0b0010000000; // Enable pulse output
                        channel_pulse_timer[ 7 ] =
                                    eeprom_read( VSCP_EEPROM_END + REG0_COUNT +
                                                    REG1_BEIJING_CH7_TIMING_PULSE_MSB) * 256 +
                                    eeprom_read( VSCP_EEPROM_END + REG0_COUNT +
                                                    REG1_BEIJING_CH7_TIMING_PULSE_LSB);
                    }
                    else {
                        channel_pulse_flags &= 0b1101111111; // Disable pulse output
                        CHANNEL7 = 0; // End with off
                        bOn = FALSE;
                    }

                    if ( val & OUTPUT_CTRL_PROTECTION ) {
                        channel_protection_timer[ 7 ] =
                            eeprom_read( VSCP_EEPROM_END + REG0_COUNT +
                                        REG1_BEIJING_CH7_TIMING_PROTECT_MSB ) * 256 +
                            eeprom_read( VSCP_EEPROM_END + REG0_COUNT +
                                        REG1_BEIJING_CH7_TIMING_PROTECT_LSB );
                    }
                    break;    

                case REG0_BEIJING_CH8_OUTPUT_CTRL:

                    eeprom_write( VSCP_EEPROM_END + reg, val );
                    rv = eeprom_read( VSCP_EEPROM_END + reg );

                    if ( val & OUTPUT_CTRL_PULSE ) {
                    
                        CHANNEL8 = 0; // Start out at a known state
                        bOn = FALSE;

                        channel_pulse_flags |= 0b0100000000; // Enable pulse output
                        channel_pulse_timer[ 8 ] =
                                    eeprom_read( VSCP_EEPROM_END + REG0_COUNT +
                                                    REG1_BEIJING_CH8_TIMING_PULSE_MSB) * 256 +
                                    eeprom_read( VSCP_EEPROM_END + REG0_COUNT +
                                                    REG1_BEIJING_CH8_TIMING_PULSE_LSB);
                    }
                    else {
                        channel_pulse_flags &= 0b1011111111; // Disable pulse output
                        CHANNEL8 = 0; // End with off
                        bOn = FALSE;
                    }

                    if ( val & OUTPUT_CTRL_PROTECTION ) {
                        channel_protection_timer[ 8 ] =
                            eeprom_read( VSCP_EEPROM_END + REG0_COUNT +
                                        REG1_BEIJING_CH8_TIMING_PROTECT_MSB ) * 256 +
                            eeprom_read( VSCP_EEPROM_END + REG0_COUNT +
                                        REG1_BEIJING_CH8_TIMING_PROTECT_LSB );
                    }
                    break;
                
                case REG0_BEIJING_CH9_OUTPUT_CTRL:

                    eeprom_write( VSCP_EEPROM_END + reg, val );
                    rv = eeprom_read( VSCP_EEPROM_END + reg );

                    if ( val & OUTPUT_CTRL_PULSE ) {
                    
                        CHANNEL9 = 0; // Start out at a known state
                        bOn = FALSE;

                        channel_pulse_flags |= 0b1000000000; // Enable pulse output
                        channel_pulse_timer[ 9 ] =
                                    eeprom_read( VSCP_EEPROM_END + REG0_COUNT +
                                                    REG1_BEIJING_CH9_TIMING_PULSE_MSB) * 256 +
                                    eeprom_read( VSCP_EEPROM_END + REG0_COUNT +
                                                    REG1_BEIJING_CH9_TIMING_PULSE_LSB);
                    }
                    else {
                        channel_pulse_flags &= 0b0111111111; // Disable pulse output
                        CHANNEL9 = 0; // End with off
                        bOn = FALSE;
                    }

                    if ( val & OUTPUT_CTRL_PROTECTION ) {
                        channel_protection_timer[ 9 ] =
                            eeprom_read( VSCP_EEPROM_END + REG0_COUNT +
                                        REG1_BEIJING_CH9_TIMING_PROTECT_MSB ) * 256 +
                            eeprom_read( VSCP_EEPROM_END + REG0_COUNT +
                                        REG1_BEIJING_CH9_TIMING_PROTECT_LSB );
                    }
                    break;        
                
            }
            
        }
        else if ( ( reg >= REG0_BEIJING_CH0_INPUT_CTRL ) && 
                    ( reg < REG0_COUNT ) ) {
            eeprom_write( VSCP_EEPROM_END + reg, val );
            rv = eeprom_read( VSCP_EEPROM_END + reg );
        }
        
    } // page 0
    
    // * * *  Page 1  * * *
    else if ( 1 == vscp_page_select ) {
    
        // Pulse time registers
        if ( (reg >= REG1_BEIJING_CH0_TIMING_PULSE_MSB ) &&
                    (reg <= REG1_BEIJING_CH9_TIMING_PULSE_LSB ) ) {

            // Write to EEPROM
            eeprom_write( VSCP_EEPROM_END + REG0_COUNT + reg, val );
            rv = eeprom_read( VSCP_EEPROM_END + REG0_COUNT + reg );

            // We let the default take care of the MSB's
            // and give some special treatment to the LSB's
            switch ( reg ) {

                case REG1_BEIJING_CH0_TIMING_PULSE_LSB:
                    channel_pulse_timer[ 0 ] =
                        eeprom_read( VSCP_EEPROM_END + REG0_COUNT +
                                    REG1_BEIJING_CH0_TIMING_PULSE_MSB ) * 256 +
                        eeprom_read( VSCP_EEPROM_END + REG0_COUNT +
                                    REG1_BEIJING_CH0_TIMING_PULSE_LSB );
                    break;

                case REG1_BEIJING_CH1_TIMING_PULSE_LSB:
                    channel_pulse_timer[ 1 ] =
                        eeprom_read( VSCP_EEPROM_END + REG0_COUNT +
                                    REG1_BEIJING_CH1_TIMING_PULSE_MSB) * 256 +
                        eeprom_read( VSCP_EEPROM_END + REG0_COUNT +
                                    REG1_BEIJING_CH1_TIMING_PULSE_LSB);
                    break;

                case REG1_BEIJING_CH2_TIMING_PULSE_LSB:
                    channel_pulse_timer[ 2 ] =
                        eeprom_read( VSCP_EEPROM_END + REG0_COUNT +
                                    REG1_BEIJING_CH2_TIMING_PULSE_MSB) * 256 +
                        eeprom_read( VSCP_EEPROM_END + REG0_COUNT +
                                    REG1_BEIJING_CH2_TIMING_PULSE_LSB);
                    break;

                case REG1_BEIJING_CH3_TIMING_PULSE_LSB:
                    channel_pulse_timer[ 3 ] =
                        eeprom_read( VSCP_EEPROM_END + REG0_COUNT +
                                    REG1_BEIJING_CH3_TIMING_PULSE_MSB) * 256 +
                        eeprom_read( VSCP_EEPROM_END + REG0_COUNT +
                                    REG1_BEIJING_CH3_TIMING_PULSE_LSB);
                    break;

                case REG1_BEIJING_CH4_TIMING_PULSE_LSB:
                    channel_pulse_timer[ 4 ] =
                        eeprom_read( VSCP_EEPROM_END + REG0_COUNT +
                                    REG1_BEIJING_CH4_TIMING_PULSE_MSB) * 256 +
                        eeprom_read( VSCP_EEPROM_END + REG0_COUNT +
                                    REG1_BEIJING_CH4_TIMING_PULSE_LSB);
                    break;

                case REG1_BEIJING_CH5_TIMING_PULSE_LSB:
                    channel_pulse_timer[ 5 ] =
                        eeprom_read( VSCP_EEPROM_END + REG0_COUNT +
                                    REG1_BEIJING_CH5_TIMING_PULSE_MSB) * 256 +
                        eeprom_read( VSCP_EEPROM_END + REG0_COUNT +
                                    REG1_BEIJING_CH5_TIMING_PULSE_LSB);
                    break;

                case REG1_BEIJING_CH6_TIMING_PULSE_LSB:
                    channel_pulse_timer[ 6 ] =
                        eeprom_read( VSCP_EEPROM_END + REG0_COUNT +
                                    REG1_BEIJING_CH6_TIMING_PULSE_MSB) * 256 +
                        eeprom_read( VSCP_EEPROM_END + REG0_COUNT +
                                    REG1_BEIJING_CH6_TIMING_PULSE_LSB);
                    break;

                case REG1_BEIJING_CH7_TIMING_PULSE_LSB:
                    channel_pulse_timer[ 7 ] =
                        eeprom_read( VSCP_EEPROM_END + REG0_COUNT +
                                    REG1_BEIJING_CH7_TIMING_PULSE_MSB) * 256 +
                        eeprom_read( VSCP_EEPROM_END + REG0_COUNT +
                                    REG1_BEIJING_CH7_TIMING_PULSE_LSB);
                    break;
                
                case REG1_BEIJING_CH8_TIMING_PULSE_LSB:
                    channel_pulse_timer[ 8 ] =
                        eeprom_read( VSCP_EEPROM_END + REG0_COUNT +
                                    REG1_BEIJING_CH8_TIMING_PULSE_MSB) * 256 +
                        eeprom_read( VSCP_EEPROM_END + REG0_COUNT +
                                    REG1_BEIJING_CH8_TIMING_PULSE_LSB);
                    break;    
                
                case REG1_BEIJING_CH9_TIMING_PULSE_LSB:
                    channel_pulse_timer[ 9 ] =
                        eeprom_read( VSCP_EEPROM_END + REG0_COUNT +
                                    REG1_BEIJING_CH9_TIMING_PULSE_MSB) * 256 +
                        eeprom_read( VSCP_EEPROM_END + REG0_COUNT +
                                    REG1_BEIJING_CH9_TIMING_PULSE_LSB);
                    break;    

                default:
                    break;
            }

        }
        // Relay protection time registers
        else if ( ( reg >= REG1_BEIJING_CH0_TIMING_PROTECT_MSB ) &&
                ( reg <= REG1_BEIJING_CH9_TIMING_PROTECT_LSB ) ) {

            // Write to EEPROM
            eeprom_write( VSCP_EEPROM_END + REG0_COUNT + reg, val );
            rv = eeprom_read( VSCP_EEPROM_END + REG0_COUNT + reg );
        
            switch ( reg ) {

                case REG1_BEIJING_CH0_TIMING_PROTECT_LSB:
                    channel_protection_timer[ 0 ] =
                        eeprom_read( VSCP_EEPROM_END + REG0_COUNT +
                                        REG1_BEIJING_CH0_TIMING_PROTECT_MSB ) * 256 +
                        eeprom_read( VSCP_EEPROM_END + REG0_COUNT +
                                        REG1_BEIJING_CH0_TIMING_PROTECT_LSB );
                    break;

                case REG1_BEIJING_CH1_TIMING_PROTECT_LSB:
                    channel_protection_timer[ 1 ] =
                        eeprom_read( VSCP_EEPROM_END + REG0_COUNT +
                                        REG1_BEIJING_CH1_TIMING_PROTECT_MSB ) * 256 +
                        eeprom_read( VSCP_EEPROM_END + REG0_COUNT +
                                        REG1_BEIJING_CH1_TIMING_PROTECT_LSB );
                    break;

                case REG1_BEIJING_CH2_TIMING_PROTECT_LSB:
                    channel_protection_timer[ 2 ] =
                        eeprom_read( VSCP_EEPROM_END + REG0_COUNT +
                                        REG1_BEIJING_CH2_TIMING_PROTECT_MSB ) * 256 +
                        eeprom_read( VSCP_EEPROM_END + REG0_COUNT +
                                        REG1_BEIJING_CH2_TIMING_PROTECT_LSB );
                    break;

                case REG1_BEIJING_CH3_TIMING_PROTECT_LSB:
                    channel_protection_timer[ 3 ] =
                        eeprom_read( VSCP_EEPROM_END + REG0_COUNT +
                                        REG1_BEIJING_CH3_TIMING_PROTECT_MSB ) * 256 +
                        eeprom_read( VSCP_EEPROM_END + REG0_COUNT +
                                        REG1_BEIJING_CH3_TIMING_PROTECT_LSB );
                    break;

                case REG1_BEIJING_CH4_TIMING_PROTECT_LSB:
                    channel_protection_timer[ 4 ] =
                        eeprom_read( VSCP_EEPROM_END + REG0_COUNT +
                                        REG1_BEIJING_CH4_TIMING_PROTECT_MSB ) * 256 +
                        eeprom_read( VSCP_EEPROM_END + REG0_COUNT +
                                        REG1_BEIJING_CH4_TIMING_PROTECT_LSB );
                    break;

                case REG1_BEIJING_CH5_TIMING_PROTECT_LSB:
                    channel_protection_timer[ 5 ] =
                        eeprom_read( VSCP_EEPROM_END + REG0_COUNT +
                                        REG1_BEIJING_CH5_TIMING_PROTECT_MSB ) * 256 +
                        eeprom_read( VSCP_EEPROM_END + REG0_COUNT +
                                        REG1_BEIJING_CH5_TIMING_PROTECT_LSB );
                    break;

                case REG1_BEIJING_CH6_TIMING_PROTECT_LSB:
                    channel_protection_timer[ 6 ] =
                        eeprom_read( VSCP_EEPROM_END + REG0_COUNT +
                                        REG1_BEIJING_CH6_TIMING_PROTECT_MSB ) * 256 +
                        eeprom_read( VSCP_EEPROM_END + REG0_COUNT +
                                        REG1_BEIJING_CH6_TIMING_PROTECT_LSB );
                    break;

                case REG1_BEIJING_CH7_TIMING_PROTECT_LSB:
                    channel_protection_timer[ 7 ] =
                        eeprom_read( VSCP_EEPROM_END + REG0_COUNT +
                                        REG1_BEIJING_CH7_TIMING_PROTECT_MSB ) * 256 +
                        eeprom_read( VSCP_EEPROM_END + REG0_COUNT +
                                        REG1_BEIJING_CH7_TIMING_PROTECT_LSB );
                    break;
                
                case REG1_BEIJING_CH8_TIMING_PROTECT_LSB:
                    channel_protection_timer[ 8 ] =
                        eeprom_read( VSCP_EEPROM_END + REG0_COUNT +
                                        REG1_BEIJING_CH8_TIMING_PROTECT_MSB ) * 256 +
                        eeprom_read( VSCP_EEPROM_END + REG0_COUNT +
                                        REG1_BEIJING_CH8_TIMING_PROTECT_LSB );
                    break; 
                
                case REG1_BEIJING_CH9_TIMING_PROTECT_LSB:
                    channel_protection_timer[ 9 ] =
                        eeprom_read( VSCP_EEPROM_END + REG0_COUNT +
                                        REG1_BEIJING_CH9_TIMING_PROTECT_MSB ) * 256 +
                        eeprom_read( VSCP_EEPROM_END + REG0_COUNT +
                                        REG1_BEIJING_CH9_TIMING_PROTECT_LSB );
                    break;    

                default:
                    break;
            }

        }
        
    } // page 1
    
    // * * *  Page 2  * * *
    else if ( 2 == vscp_page_select ) {
    
        if ( reg < (REG_DESCION_MATRIX + DESCION_MATRIX_ROWS * 8) ) {
            eeprom_write( VSCP_EEPROM_END + 
                            REG_DESCION_MATRIX +
                            REG0_COUNT + 
                            REG1_COUNT + 
                            reg, val );
            calculateSetFilterMask();  // Calculate new hardware filter
            rv = eeprom_read( VSCP_EEPROM_END + 
                            REG_DESCION_MATRIX + 
                            REG0_COUNT + 
                            REG1_COUNT + 
                            reg );
        }
        
    } // page 2
        
    // --------------------------------------------------------------------------

    // Send information Event
    // if enabled in the registers
    if ( bInfoEvent ) {

        unsigned char val;
        val = eeprom_read( VSCP_EEPROM_END + 
                            REG0_BEIJING_CH0_STATUS + 
                            ( reg - REG0_BEIJING_CH0_STATUS ) );

        if ( bOn ) {

            if ( val & OUTPUT_CTRL_ONEVENT ) {
                SendInformationEvent( reg - REG0_BEIJING_CH0_STATUS,
                                        VSCP_CLASS1_INFORMATION,
                                        VSCP_TYPE_INFORMATION_ON );
            }

        }
        else {

            if ( val & OUTPUT_CTRL_OFFEVENT ) {
                SendInformationEvent( reg - REG0_BEIJING_CH0_STATUS,
                                        VSCP_CLASS1_INFORMATION,
                                        VSCP_TYPE_INFORMATION_OFF );
            }
            
        }
    }

    return rv;

}

///////////////////////////////////////////////////////////////////////////////
// Send Decision Matrix Information
//

void sendDMatrixInfo(void)
{
    vscp_omsg.priority = VSCP_PRIORITY_MEDIUM;
    vscp_omsg.flags = VSCP_VALID_MSG + 2;
    vscp_omsg.vscp_class = VSCP_CLASS1_PROTOCOL;
    vscp_omsg.vscp_type = VSCP_TYPE_PROTOCOL_GET_MATRIX_INFO_RESPONSE;

    vscp_omsg.data[ 0 ] = DESCION_MATRIX_ROWS;
    vscp_omsg.data[ 1 ] = REG_DESCION_MATRIX;

    vscp_sendEvent(); // Send data
}


///////////////////////////////////////////////////////////////////////////////
// SendInformationEvent
//

void SendInformationEvent( unsigned char idx,
                            unsigned char eventClass,
                            unsigned char eventTypeId )
{
    uint8_t data[3];

    data[ 0 ] = idx; // Register
    data[ 1 ] = eeprom_read( VSCP_EEPROM_END + REG0_BEIJING_ZONE );
    data[ 2 ] = eeprom_read( VSCP_EEPROM_END + REG0_BEIJING_CH0_SUBZONE + idx );
    sendVSCPFrame( eventClass,
                    eventTypeId,
                    vscp_nickname,
                    VSCP_PRIORITY_MEDIUM,
                    3,
                    data );
}

///////////////////////////////////////////////////////////////////////////////
// Do decision Matrix handling
// 
// The routine expects vscp_imsg to contain a valid incoming event
//

void doDM( void )
{
    unsigned char i;
    unsigned char dmflags;
    unsigned short class_filter;
    unsigned short class_mask;
    unsigned char type_filter;
    unsigned char type_mask;

    // Don't deal with the protocol functionality
    if ( VSCP_CLASS1_PROTOCOL == vscp_imsg.vscp_class ) return;

    for (i = 0; i<DESCION_MATRIX_ROWS; i++) {

        // Get DM flags for this row
        dmflags = eeprom_read( VSCP_EEPROM_END + 
                                    REG0_COUNT + 
                                    REG1_COUNT + 
                                    REG_DESCION_MATRIX + 
                                    VSCP_DM_POS_FLAGS + 
                                    (8 * i) );

        // Is the DM row enabled?
        if ( dmflags & VSCP_DM_FLAG_ENABLED ) {

            // Should the originating id be checked and if so is it the same?
            if ( ( dmflags & VSCP_DM_FLAG_CHECK_OADDR ) &&
                    ( vscp_imsg.oaddr != eeprom_read( VSCP_EEPROM_END + REG0_COUNT + REG1_COUNT + REG_DESCION_MATRIX + (8 * i) ) ) ) {
                continue;
            }

            // Check if zone should match and if so if it match
            if ( dmflags & VSCP_DM_FLAG_CHECK_ZONE ) {
                if ( 255 != vscp_imsg.data[ 1 ] ) {
                    if ( vscp_imsg.data[ 1 ] != eeprom_read( VSCP_EEPROM_END + REG0_BEIJING_ZONE ) ) {
                        continue;
                    }
                }
            }

            // Check if sub zone should match and if so if it match
            if ( dmflags & VSCP_DM_FLAG_CHECK_SUBZONE ) {
                if ( 255 != vscp_imsg.data[ 2 ] ) {
                    if ( vscp_imsg.data[ 2 ] != eeprom_read( VSCP_EEPROM_END + REG0_BEIJING_SUBZONE ) ) {
                        continue;
                    }
                }
            }
            
            class_filter = ( ( dmflags & VSCP_DM_FLAG_CLASS_FILTER) << 8 ) +
                    eeprom_read( VSCP_EEPROM_END +
                                    REG0_COUNT + REG1_COUNT + 
                                    REG_DESCION_MATRIX +
                                    (8 * i) +
                                    VSCP_DM_POS_CLASSFILTER);
            
            class_mask = ( ( dmflags & VSCP_DM_FLAG_CLASS_MASK ) << 7 ) +
                    eeprom_read( VSCP_EEPROM_END +
                                    REG0_COUNT + REG1_COUNT + 
                                    REG_DESCION_MATRIX +
                                    (8 * i) +
                                    VSCP_DM_POS_CLASSMASK);
            
            type_filter = eeprom_read( VSCP_EEPROM_END +
                                        REG0_COUNT + REG1_COUNT + 
                                        REG_DESCION_MATRIX +
                                        (8 * i) +
                                        VSCP_DM_POS_TYPEFILTER);
            
            type_mask = eeprom_read( VSCP_EEPROM_END +
                                        REG0_COUNT + REG1_COUNT + 
                                        REG_DESCION_MATRIX +
                                        (8 * i) +
                                        VSCP_DM_POS_TYPEMASK);
                           
            if ( !( ( class_filter ^ vscp_imsg.vscp_class ) & class_mask ) &&
                    !( ( type_filter ^ vscp_imsg.vscp_type ) & type_mask ) ) {

                // OK Trigger this action
                switch ( eeprom_read( VSCP_EEPROM_END + 
                                        REG0_COUNT + REG1_COUNT + 
                                        REG_DESCION_MATRIX + (8 * i) + VSCP_DM_POS_ACTION ) ) {

                    case BEIJING_ACTION_NOOP:
                        break;
                        
                    case BEIJING_ACTION_SET:        // Enable Channels in arg. bit arry
                        doActionOn( dmflags, eeprom_read( VSCP_EEPROM_END + 
                                                            REG0_COUNT + REG1_COUNT + 
                                                            REG_DESCION_MATRIX + (8 * i) + VSCP_DM_POS_ACTIONPARAM ) );
                        break;

                    case BEIJING_ACTION_CLR:        // Disable Channels in arg. bitarry
                        doActionOff( dmflags, eeprom_read( VSCP_EEPROM_END + 
                                                            REG0_COUNT + REG1_COUNT + 
                                                            REG_DESCION_MATRIX + (8 * i) + VSCP_DM_POS_ACTIONPARAM ) );
                        break;

                    case BEIJING_ACTION_PULSEON:    // Pulse Channels in arg. bitarry, zone, subzone
                        doActionPulseOn( dmflags, eeprom_read( VSCP_EEPROM_END + 
                                                                REG0_COUNT + REG1_COUNT + 
                                                                REG_DESCION_MATRIX + (8 * i) + VSCP_DM_POS_ACTIONPARAM ) );
                        break;
                        
                    case BEIJING_ACTION_PULSEOFF:   // Pulse Channels in arg. bitarry, zone, subzone
                        doActionPulseOff( dmflags, eeprom_read( VSCP_EEPROM_END + 
                                                                REG0_COUNT + REG1_COUNT + 
                                                                REG_DESCION_MATRIX + (8 * i) + VSCP_DM_POS_ACTIONPARAM ) );
                        break;    

                    case BEIJING_ACTION_STATUS:     // Send status for all Channels
                        doActionStatus( dmflags, eeprom_read( VSCP_EEPROM_END + 
                                                                REG0_COUNT + REG1_COUNT + 
                                                                REG_DESCION_MATRIX + (8 * i) + VSCP_DM_POS_ACTIONPARAM ) );
                        break;
                        
                    case BEIJING_ACTION_STATUSALL: // Send status for all Channels
                        doActionStatusAll( dmflags, eeprom_read( VSCP_EEPROM_END + 
                                                                REG0_COUNT + REG1_COUNT + 
                                                                REG_DESCION_MATRIX + (8 * i) + VSCP_DM_POS_ACTIONPARAM ) );
                        break;    

                    case BEIJING_ACTION_TOGGLE:     // Toggle Channels
                        doActionToggle( dmflags, eeprom_read( VSCP_EEPROM_END + 
                                                                REG0_COUNT + REG1_COUNT + 
                                                                REG_DESCION_MATRIX + (8 * i) + VSCP_DM_POS_ACTIONPARAM ) );
                        break;
                        
                    case BEIJING_ACTION_SHORTPULSE: // Short pulse on Channels
                        {
                            uint8_t param = eeprom_read( VSCP_EEPROM_END + 
                                                                REG0_COUNT + REG1_COUNT + 
                                                                REG_DESCION_MATRIX + (8 * i) + VSCP_DM_POS_ACTIONPARAM );
                            if ( vscp_imsg.data[ 0 ] ==  eeprom_read( VSCP_EEPROM_END + REG0_BEIJING_CH0_SUBZONE + param ) ) {
                                doActionShortPulse( dmflags, param );
                            }
                        }
                        break;    

                } // case
                
            } // Filter/mask
            
        } // Row enabled
        
    } // for each row
    
}

///////////////////////////////////////////////////////////////////////////////
// doActionOn
// 

void doActionOn( unsigned char dmflags, unsigned char arg )
{
    unsigned char ctrlreg;
    BOOL bEvent = FALSE;
    
    // Check for a valid argument
    if ( arg > 9 ) return;

    ctrlreg = eeprom_read( VSCP_EEPROM_END + REG0_BEIJING_CH0_OUTPUT_CTRL + arg );

    // Do nothing if disabled
    if ( !( ctrlreg & OUTPUT_CTRL_ENABLED ) ) return;

    switch ( arg ) {

        case 0:
            if ( 0 == CHANNEL0 ) bEvent = TRUE;
            CHANNEL0 = 1; 
            break;

        case 1:
            if ( 0 == CHANNEL1 ) bEvent = TRUE;
            CHANNEL1 = 1;
            break;

        case 2:
            if ( 0 == CHANNEL2 ) bEvent = TRUE;
            CHANNEL2 = 1;
            break;

        case 3:
            if ( 0 == CHANNEL3 ) bEvent = TRUE;
            CHANNEL3 = 1;
            break;

        case 4:
            if ( 0 == CHANNEL4 ) bEvent = TRUE;
            CHANNEL4 = 1;
            break;

        case 5:
            if ( 0 == CHANNEL5 ) bEvent = TRUE;
            CHANNEL5 = 1;
            break;

        case 6:
            if ( 0 == CHANNEL6 ) bEvent = TRUE;
            CHANNEL6 = 1;
            break;
                
        case 7:
            if ( 0 == CHANNEL7 ) bEvent = TRUE;
            CHANNEL7 = 1;
            break;
                
        case 8:
            if ( 0 == CHANNEL8 ) bEvent = TRUE;
            CHANNEL8 = 1;
            break;    
                
        case 9:
            if ( 0 == CHANNEL9 ) bEvent = TRUE;
            CHANNEL9 = 1;
            break;    

    }
    
    if ( ctrlreg & OUTPUT_CTRL_PROTECTION ) {
        channel_protection_timer[ arg ] =
                eeprom_read( VSCP_EEPROM_END + 
                                REG0_COUNT +
                                REG1_BEIJING_CH0_TIMING_PROTECT_MSB + 
                                2 * arg ) * 256 +
                eeprom_read( VSCP_EEPROM_END + 
                                REG0_COUNT +
                                REG1_BEIJING_CH0_TIMING_PROTECT_LSB  + 
                                2 * arg );
    }

    // Should off event be sent?
    if ( bEvent && ( ctrlreg & OUTPUT_CTRL_ONEVENT ) ) {
        SendInformationEvent( arg, VSCP_CLASS1_INFORMATION, VSCP_TYPE_INFORMATION_ON );
    }

}

///////////////////////////////////////////////////////////////////////////////
// doActionOff
// 

void doActionOff( unsigned char dmflags, unsigned char arg )
{
    unsigned char ctrlreg;
    BOOL bEvent = FALSE;
    
    // Check for a valid argument
    if ( arg > 9 ) return;

    ctrlreg = eeprom_read( VSCP_EEPROM_END + REG0_BEIJING_CH0_OUTPUT_CTRL + arg );

    // Do nothing if disabled
    if ( !( ctrlreg & OUTPUT_CTRL_ENABLED ) ) return;

    switch ( arg ) {

        case 0:
            if ( 1 == CHANNEL0 ) bEvent = TRUE;
            CHANNEL0 = 0; 
            break;

        case 1:
            if ( 1 == CHANNEL1 ) bEvent = TRUE;            
            CHANNEL1 = 0;
            break;

        case 2:
            if ( 1 == CHANNEL2 ) bEvent = TRUE;
            CHANNEL2 = 0;
            break;

        case 3:
            if ( 1 == CHANNEL3 ) bEvent = TRUE;
            CHANNEL3 = 0;
            break;

        case 4:
            if ( 1 == CHANNEL4 ) bEvent = TRUE;
            CHANNEL4 = 0;
            break;

        case 5:
            if ( 1 == CHANNEL5 ) bEvent = TRUE;
            CHANNEL5 = 0;
            break;

        case 6:
            if ( 1 == CHANNEL6 ) bEvent = TRUE;
            CHANNEL6 = 0;
            break;
                
        case 7:
            if ( 1 == CHANNEL7 ) bEvent = TRUE;
            CHANNEL7 = 0;
            break;
                
        case 8:
            if ( 1 == CHANNEL8 ) bEvent = TRUE;
            CHANNEL8 = 0;
            break;    
                
        case 9:
            if ( 1 == CHANNEL9 ) bEvent = TRUE;
            CHANNEL9 = 0;
            break;    

    }
    
    // Should off event be sent?
    if ( bEvent && ( ctrlreg & OUTPUT_CTRL_OFFEVENT ) ) {
        SendInformationEvent( arg, VSCP_CLASS1_INFORMATION, VSCP_TYPE_INFORMATION_OFF );
    }
}

///////////////////////////////////////////////////////////////////////////////
// doActionPulseOn
// 

void doActionPulseOn(unsigned char dmflags, unsigned char arg)
{
    unsigned char ctrlreg;
    BOOL bEvent = FALSE;
    
    // Check for a valid argument
    if ( arg > 9 ) return;

    ctrlreg = eeprom_read( VSCP_EEPROM_END + REG0_BEIJING_CH0_OUTPUT_CTRL + arg );

    // Do nothing if disabled
    if ( !( ctrlreg & OUTPUT_CTRL_ENABLED ) ) return;

    switch ( arg ) {

        case 0:
            if ( 1 == CHANNEL0 ) bEvent = TRUE;
            CHANNEL0 = 0; // Start out at a known state
            break;

        case 1:
            if ( 1 == CHANNEL1 ) bEvent = TRUE;
            CHANNEL1 = 0;
            break;

        case 2:
            if ( 1 == CHANNEL2 ) bEvent = TRUE;
            CHANNEL2 = 0;
            break;

        case 3:
            if ( 1 == CHANNEL3 ) bEvent = TRUE;
            CHANNEL3 = 0;
            break;

        case 4:
            if ( 1 == CHANNEL4 ) bEvent = TRUE;
            CHANNEL4 = 0;
            break;

        case 5:
            if ( 1 == CHANNEL5 ) bEvent = TRUE;
            CHANNEL5 = 0;
            break;

        case 6:
            if ( 1 == CHANNEL6 ) bEvent = TRUE;
            CHANNEL6 = 0;
            break;
                
        case 7:
            if ( 1 == CHANNEL7 ) bEvent = TRUE;
            CHANNEL7 = 0;
            break;
                
        case 8:
            if ( 1 == CHANNEL8 ) bEvent = TRUE;
            CHANNEL8 = 0;
            break;    
                
        case 9:
            if ( 1 == CHANNEL9 ) bEvent = TRUE;
            CHANNEL9 = 0;
            break;    

    }
    
    // Should off event be sent?
    if ( bEvent && ( ctrlreg & OUTPUT_CTRL_OFFEVENT ) ) {
        SendInformationEvent( arg, VSCP_CLASS1_INFORMATION, VSCP_TYPE_INFORMATION_OFF );
    }
    
    channel_pulse_flags |= ( 1 << arg ); // Enable pulse output
    channel_pulse_timer[ 0 ] =
            eeprom_read( VSCP_EEPROM_END + REG0_COUNT +
                            REG1_BEIJING_CH0_TIMING_PULSE_MSB + arg ) * 256 +
            eeprom_read( VSCP_EEPROM_END + REG0_COUNT +
                            REG1_BEIJING_CH0_TIMING_PULSE_LSB + arg );
}

///////////////////////////////////////////////////////////////////////////////
// doActionPulseOff
// 

void doActionPulseOff(unsigned char dmflags, unsigned char arg)
{
    unsigned char ctrlreg;
    BOOL bEvent = FALSE;
    
    // Check for a valid argument
    if ( arg > 9 ) return;

    ctrlreg = eeprom_read( VSCP_EEPROM_END + REG0_BEIJING_CH0_OUTPUT_CTRL + arg );

    // Do nothing if disabled
    if ( !( ctrlreg & OUTPUT_CTRL_ENABLED ) ) return;

    switch ( arg ) {

        case 0:
            if ( 1 == CHANNEL0 ) bEvent = TRUE;
            CHANNEL0 = 0; // Start out at a known state
            break;

        case 1:
            if ( 1 == CHANNEL1 ) bEvent = TRUE;
            CHANNEL1 = 0;
            break;

        case 2:
            if ( 1 == CHANNEL2 ) bEvent = TRUE;
            CHANNEL2 = 0;
            break;

        case 3:
            if ( 1 == CHANNEL3 ) bEvent = TRUE;
            CHANNEL3 = 0;
            break;

        case 4:
            if ( 1 == CHANNEL4 ) bEvent = TRUE;
            CHANNEL4 = 0;
            break;

        case 5:
            if ( 1 == CHANNEL5 ) bEvent = TRUE;
            CHANNEL5 = 0;
            break;

        case 6:
            if ( 1 == CHANNEL6 ) bEvent = TRUE;
            CHANNEL6 = 0;
            break;
                
        case 7:
            if ( 1 == CHANNEL7 ) bEvent = TRUE;
            CHANNEL7 = 0;
            break;
                
        case 8:
            if ( 1 == CHANNEL8 ) bEvent = TRUE;
            CHANNEL8 = 0;
            break;    
                
        case 9:
            if ( 1 == CHANNEL9 ) bEvent = TRUE;
            CHANNEL9 = 0;
            break;    

    }
    
    // Should off event be sent?
    if ( bEvent && ( ctrlreg & OUTPUT_CTRL_OFFEVENT ) ) {
        SendInformationEvent( arg, VSCP_CLASS1_INFORMATION, VSCP_TYPE_INFORMATION_OFF );
    }
    
    channel_pulse_flags &= ~( 1 << arg ); // Disable pulse output
}


///////////////////////////////////////////////////////////////////////////////
// doActionToggle
// 

void doActionToggle( unsigned char dmflags, unsigned char arg )
{
    unsigned char ctrlreg;
    BOOL bOn = FALSE;
    
    // Check for a valid argument
    if ( arg > 9 ) return;

    ctrlreg = eeprom_read( VSCP_EEPROM_END + REG0_BEIJING_CH0_OUTPUT_CTRL + arg );

    // Do nothing if disabled
    if ( !( ctrlreg & OUTPUT_CTRL_ENABLED ) ) return;

    switch ( arg ) {

        case 0:
            if ( CHANNEL0 ) {
                CHANNEL0 = 0;
                bOn = FALSE;
            } 
            else {
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
    
    }

    if ( bOn ) {

        // Should off event be sent?
        if ( ctrlreg & OUTPUT_CTRL_OFFEVENT ) {
            SendInformationEvent( arg, 
                                    VSCP_CLASS1_INFORMATION, 
                                    VSCP_TYPE_INFORMATION_OFF );
        }

    }
    else {
        // Should off event be sent?
        if ( ctrlreg & OUTPUT_CTRL_OFFEVENT ) {
            SendInformationEvent( arg, 
                                    VSCP_CLASS1_INFORMATION, 
                                    VSCP_TYPE_INFORMATION_OFF );
        }
    }
}


///////////////////////////////////////////////////////////////////////////////
// doActionStatusAll
// 

void doActionStatusAll(unsigned char dmflags, unsigned char arg)
{
    uint8_t i;
    
    for ( i=0; i<9; i++ ) {
        doActionStatus( dmflags, i );
    }
  
}


///////////////////////////////////////////////////////////////////////////////
// doActionShortPulse
//
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
