grodansparadis/can4vscp_beijing/(commit log)

2015-06-15 Initial checkin
    [beijing_rev_A.brd, beijing_rev_A.sch, beijing_rev_B.brd, beijing_rev_B.sch, bejing_a0_B.brd, bejing_a0_B.sch, bejing_io_rev_A.brd, bejing_io_rev_A.sch]
2015-06-15 Cleaing up some junk
    [bejing_a0_B.brd, bejing_a0_B.sch]
2015-06-15 Moved old design out of the way.
    [bejing_io_rev_A.brd, bejing_io_rev_A.sch, bejing_io_rev_B.brd, bejing_io_rev_B.sch]
2015-07-27 Fixed problem with send timeout
    [main.c]
2015-11-10 Fixed bug: start up initialization of I/O 7 was not initialized. Dynamic filter calculations was not done when DM was initialized.
    [beijing.h, main.c, version.h]
2015-11-17 Request for decision matrix information returned invalid information. Fixed
    [beijing.h, main.c]
2015-11-27 Fixed bug that caused channel 8/9 channels not to work in button input mode
    [main.c, version.h]
2015-12-17 Changed copyright info in headers so it is correct
    [beijing.h, main.c, main.h, version.h, vscp_compiler.h, vscp_projdefs.h]
2015-12-22 Added connector images
2016-03-08 Sync between systems
    [beijing_rev_A.brd, beijing_rev_A.sch, beijing_rev_B.brd, beijing_rev_B.sch]
2016-04-04 Changed value of C14 to 10uF
    [beijing_rev_B.brd, beijing_rev_B.sch]
2016-04-11 vscp_getMatrixInfo nw use the pointer supplied by the framework.
2016-04-19 RA4 set to input to prevent collision with VCAP circuits in PIC18F2580. Brown out raised to maximum (3V & 4.6V). Valuable input from Anders Forsgren, AJE Electronics AB.
    [main.c]
2016-05-12 Wrong mask used. Thanks Steve
    [main.c]
2016-05-17 Acrion on for channel 9 wrong, fixed. Credits Steve Skula
    [main.c]
2016-05-17 Fixed typo in doActionOff, do ActionPulseOn and do ActionPulseOff Credets Steve S.
    [main.c]
2016-10-13 Added a new action shortpulse and a new register (0:47) for the timing. The shortpulse functionality is intended for bistable relays.
    [beijing.h, main.c]
2016-10-20 Added missing on-event flaggings as ntified by Steve Skula
    [main.c]
2016-10-21 Added subzone specific check to short pulse
    [main.c]
2016-10-24 Fixed init. problem for protection timer reported by Steve Skula
    [main.c]
2016-10-24 on/off events now only when enabled also for short pulse
    [main.c]
2020-05-14 init button now at 2500 ms, seconds counter fixed. VSCP core 1.6.3
    [main.c, version.h]
2020-10-28 kicad conversion of schema and board
    [beijing_rev_B.kicad_pcb, beijing_rev_B.sch]
2025-08-18 Convert schema to kicad
    [beijing_rev_B.kicad_pcb, beijing_rev_B.kicad_sch, diff.txt]
2025-09-05 Initial manual
    [diff.txt]
